sgarcia15/Heimdall/Recursos/Raspberry_Pi_Zero_ver_1.3_3_of_3_1024x1024.jpg

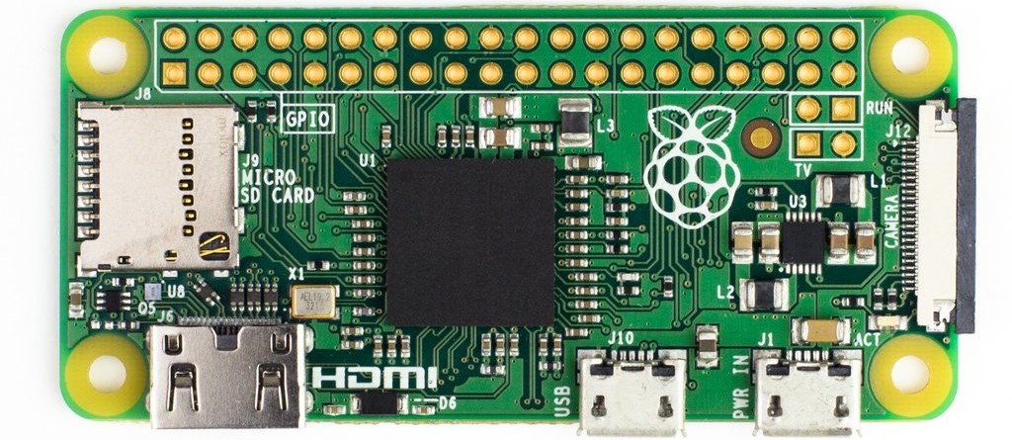
Recursos/Raspberry_Pi_Zero_ver_1.3_3_of_3_1024x1024.jpg
