sgarcia15/Heimdall/Recursos/CamVisible.jpg

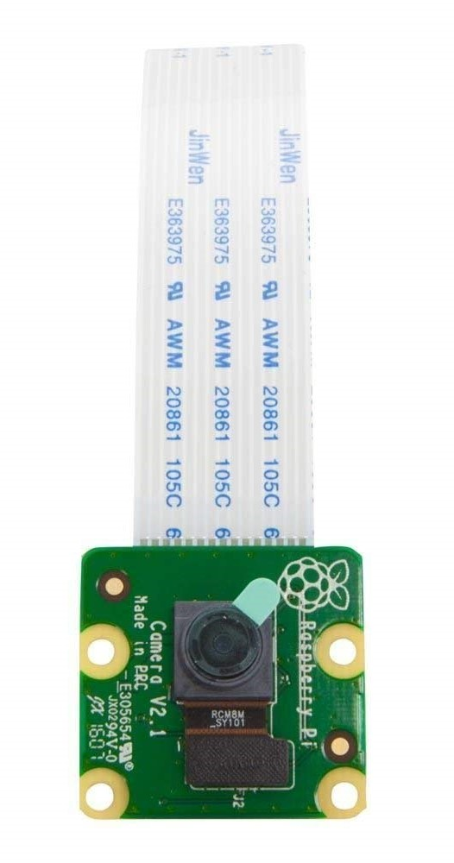
Recursos/CamVisible.jpg
