sgarcia15/Heimdall/Recursos/2017-10-14T00 17 29.457Z-Lepton Breakout Board - 2.5 - s.png

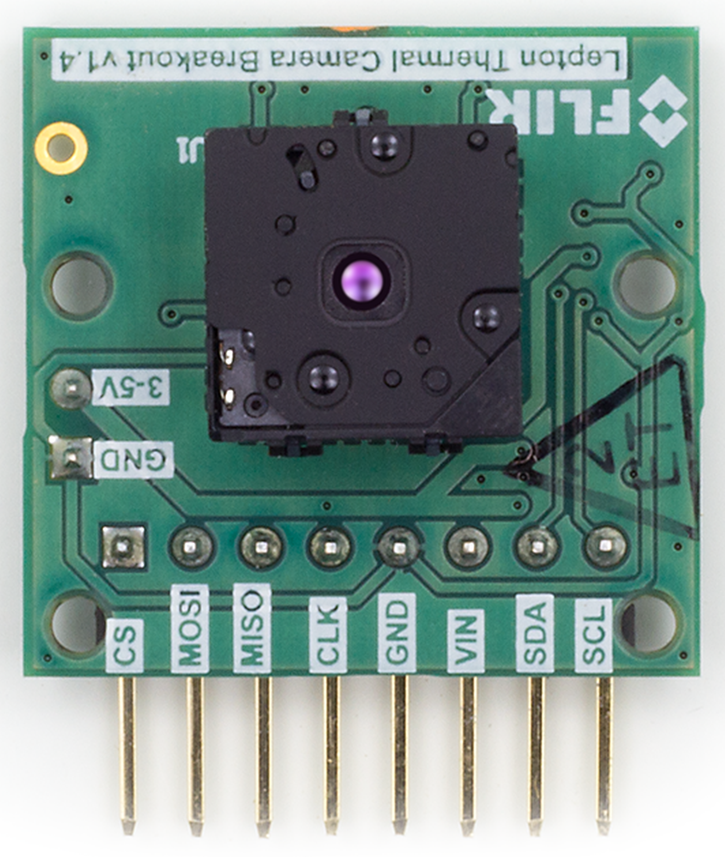
Recursos/2017-10-14T00 17 29.457Z-Lepton Breakout Board - 2.5 - s.png
