sgarcia15/Heimdall/Recursos/bitmap_tic150.png

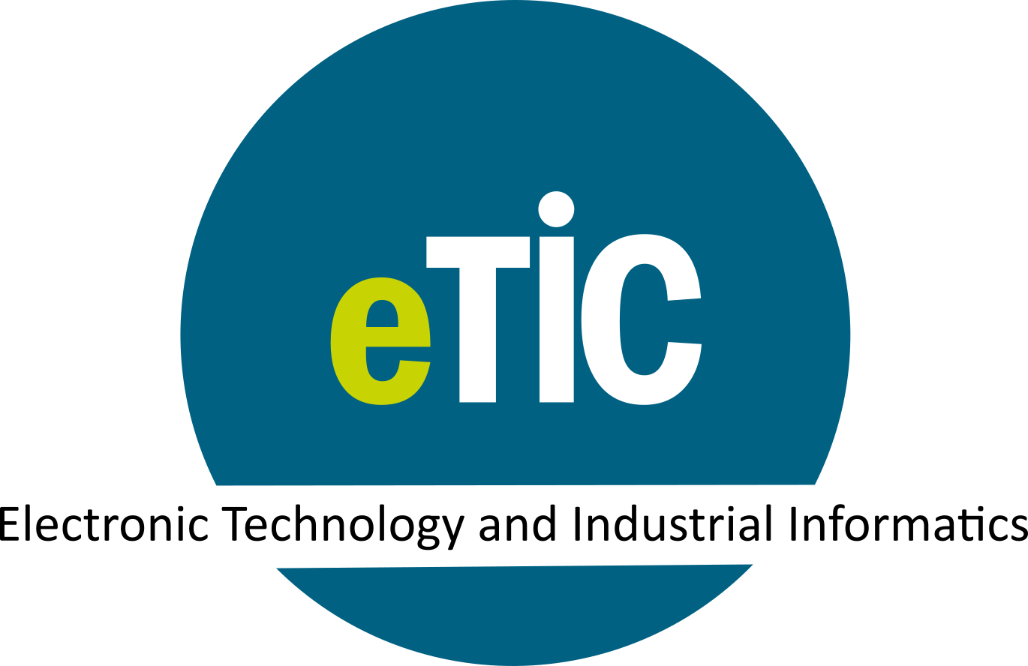
Recursos/bitmap_tic150.png
