sgarcia15/Heimdall/Recursos/bitmap_tic150_BN_nolet.png

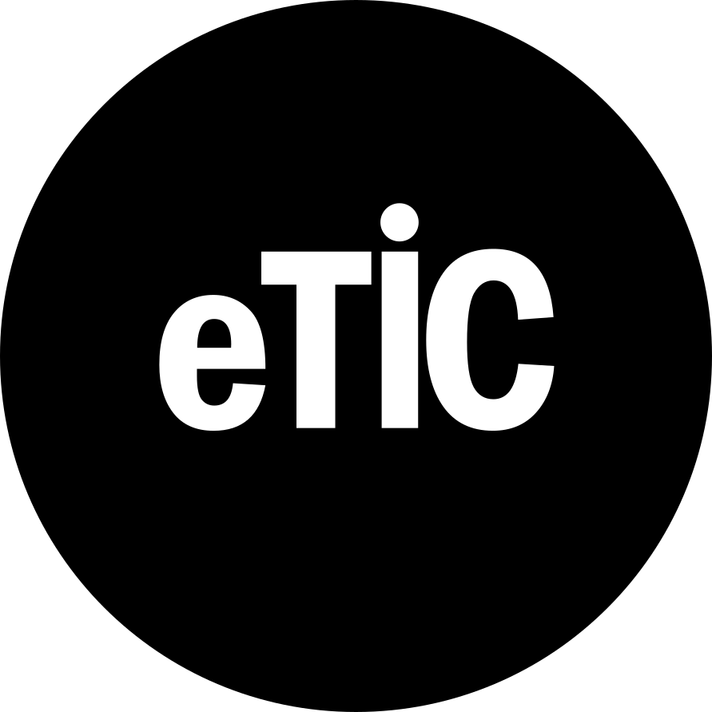
Recursos/bitmap_tic150_BN_nolet.png
