sgarcia15/Heimdall/BOM.xlsx

Sheet: Hoja1
Item | Schematic Ref | Qty | Category | Description | Part Number | Specific Part Number | Manufacturer | Comments | Packaging | Supplier | Supplier Ref | Alternative supplier | Sample? | Unit Price € | Total € |  | Total price
1 | U7 | 1 | PowerSupply | IC REG BUCK ADJ 3A SYNC 8SOICIC REG BUCK ADJ 3A SYNC 8SOIC | NCP3170B | NCP3170BDR | ON Semiconductor | Seleccted by Fran, It doesn't work well with low loads according to the datasheet. Ordered by Fran, we have 30, | SO-8 | Digikey | NCP3170BDR2GOSCT-ND |  | N | 0.972 | 0.972 |  | 0
 | U1 | 1 | PowerSupply | IC REG BUCK 3.3V 0.5A 8SOIC | MAX5033 | MAX5033AUSA | Maxim | Tested in the SEA proyect, works well with low loads | SO-8 | Digikey | MAX5033AUSA+-ND |  | Y | 2.985 | 2.985 |  | 0
 | U3 | 1 | Microcontroller | IC ARM® Cortex®-M3 STM32L1 32-bits 32 MHz Memoria FLASH 384 KB (384 K x 8) | STM32L162 | STM32L162RDT6 | STMicroelectronics | Price based on 10 units | 64-LQFP | Digikey | 497-17537-ND |  | N | 5.575 | 5.575 |  | 0
 | U6 | 1 | Digital Compass | Digital output magnetic sensor: ultra-low-power, high-performance 3-axis magnetometer | LIS2MDL | LIS2MDLTR | STMicroelectronics |  | 12-LGA | Digikey | 497-17588-1-ND |  | N | 1.399 | 1.399 |  | 0
 |  | 1 | Sensor | Humidity Temperature Sensor 0 ~ 100% RH I²C ±3% RH | HTU21D | HTU21D(F) | TE Connectivity |  | 6-DFN | Digikey | 223-1591-1-ND |  | N | 2.638 | 2.638 |  | 0
 | U8 | 1 | Thermal Camera | THERMAL IMAGE SENSOR 160HX120V | Lepton 3 | Lepton 3 | FLIR | This doesn't have the radiometry calibrated. The lepton 3,5 has the internal calibration but it isn't available on Digikey |  | Digikey | 500-0726-01-ND | Groupgets | N | 204.06 | 204.06 |  | 0
 |  | 1 | Camera | RASPBERRY PI CAMERA MODULE V2 |  |  | Raspberry Pi |  |  | Digikey | 1690-1011-ND | Amazon, Aliexpress | N | 25.53 | 25.53 |  | 0
 | U5 | 1 | Darlinton IC | ULN2003
 |  |  | Op Amp | General Purpose Quadruple Operational Amplifiers | LM324 | LM324DR | Texas Instruments |  | SOIC-14 | Digikey | 296-14597-1-ND |  | N | 0.252 | 0 |  | 0
 |  |  |  |  |  |  |  |  |  |  |  |  |  |  | 0 |  | 0
 | C1,C6,C7,C8,C9,C12,C13,C18,C20,C23,C24 | 11 | Ceramic Capacitor | CAP CER 0.1UF (100NF) 16V Y5V 0603 |  |  | Samsung Electro-Mechanics | General decoupling capacitor | 0603 | Digikey | 1276-1258-1-ND |  | N | 0.01032 | 0.11352 |  | 0
 | C19 | 1 | Ceramic Capacitor | CAP CER 0805 2.2NF 250V X7R 10% |  |  | KEMET | For the 5V power supply | 0805 | Digikey | 399-16649-1-ND |  | N | 0.161 | 0.161 |  | 0
 | C17, C22 | 2 | Ceramic Capacitor | CAP CER 22UF 6.3V 0805 |  |  |  | Ordered by Fran, we have 100, | 0805 | Digikey |  |  | N |  | 0 |  | 0
 | C16 | 1 | Ceramic Capacitor | CAP CER 10UF 6.3V X5R 0603 |  |  | Samsung Electro-Mechanics | For the digital compass | 0603 | Digikey | 1276-1119-1-ND |  | N | 0.104 | 0.104 |  | 0
 | C2 | 1 | Ceramic Capacitor | CAP CER 10000PF (10nF) 50V X7R 0603 |  |  | TDK Corporation | For the analog supply of the STM32 | 0603 | Digikey | 445-1311-1-ND |  | N | 0.026 | 0.026 |  | 0
 | C15 | 1 | Ceramic Capacitor | CAP CER 4.7UF 10V X5R 0603 |  |  | Samsung Electro-Mechanics | For the STM32 supply | 0603 | Digikey | 1276-6684-1-ND |  | N | 0.089 | 0.089 |  | 0
 | C10 | 1 | Electrolitic Capacitor | CAP ALUM 100UF 20% 25V SMD 160mOhm | EEE-FPE101XAP | EEE-FPE101XAP | Panasonic Electronic Components | Input capacitor | 6,3x5,8 | Digikey | PCE4546CT-ND |  | N | 0.42 | 0.42 |  | 0
 | C3,C4 | 2 | Ceramic Capacitor | CAP CER 12PF 10V C0G/NP0 0603 |  |  | Vishay Vitramon | Crystal decoupling capacitors | 0603 | Digikey | 720-1655-1-ND |  | N | 0.121 | 0.242 |  | 0
 | C21 | 1 | Ceramic Capacitor | CAP CER 0.22UF 16V X7R 0603 |  |  | Samsung Electro-Mechanics | For the digital compass | 0603 | Digikey | 1276-2010-1-ND |  | N | 0.0303 | 0.0303 |  | 0
 | C11 | 1 | Electrolitic Capacitor | CAP ALUM 33UF 20% 25V SMD | EEE-FP1E330AP | EEE-FP1E330AP | Panasonic Electronic Components | Low ESR 250mOhm for the 3,3V supply. | 6,3x7,7 | Digikey | PCE4541CT-ND |  | N | 0.339 | 0.339 |  | 0
 | C5 | 1 | Ceramic Capacitor | 1uF |  |  |  | Not ordered
 |  |  |  |  |  |  |  |  |  |  |  |  | N |  | 0 |  | 0
 | R8 | 1 | Resistor | 1/10 W ±1% 255 kOhms Película gruesa 0603 |  |  | Rohm Semiconductor |  | 0603 | Digikey | RHM255KCFCT-ND |  | N | 0.009 | 0.009 |  | 0
 | R1, R7 | 2 | Resistor | 1M OHM 5% 1/10W 0603 |  |  | Stackpole Electronics Inc. |  | 0603 | Digikey | RMCF0603JT1M00CT-ND |  | N | 0.011 | 0.022 |  | 0
 | R2,R9,R10,R11,R22,R23 | 6 | Resistor | 10K OHM 5% 1/10W 0603 |  |  | Stackpole Electronics Inc. |  | 0603 | Digikey | RMCF0603JG10K0CT-ND |  | N | 0.004 | 0.024 |  | 0
 | R3,R6,R12,R14,R20,R21 | 6 | Resistor | 100K OHM 1% 1/10W 0603 |  |  | Stackpole Electronics Inc. |  | 0603 | Digikey | RMCF0603FT100KCT-ND |  | N | 0.0059 | 0.0354 |  | 0
 | R15 | 1 | Resistor | 8.25K OHM 1% 1/10W 0603 |  |  | Stackpole Electronics Inc. | Filter for the 5V power supply | 0603 | Digikey | RMCF0603FT8K25CT-ND |  | N | 0.015 | 0.015 |  | 0
 | R4,R5,R18 | 3 | Resistor | 4.75K OHM 1% 1/10W 0603 |  |  | Stackpole Electronics Inc. |  | 0603 | Digikey | RMCF0603FT4K75CT-ND |  | N | 0.0059 | 0.0177 |  | 0
 | R17 | 2 | Resistor | 24.9K OHM 1% 1/8W 0603 |  |  | Stackpole Electronics Inc. |  | 0603 | Digikey | RNCP0603FTD24K9CT-ND |  | N | 0.0105 | 0.021 |  | 0
 | R13,R16,R19 | 3 | Resistor | 330 OHM 5% 1/10W 0603 |  |  | Stackpole Electronics Inc. | For the LEDs | 0603 | Digikey | RMCF0603JT330RCT-ND |  | N | 0.011 | 0.033 |  | 0
 |  |  |  |  |  |  |  |  |  |  |  |  | N |  | 0 |  | 0
 |  |  |  |  |  |  |  |  |  |  |  |  | N |  | 0 |  | 0
 |  |  |  |  |  |  |  |  |  |  |  |  | N |  | 0 |  | 0
 | Q1,Q2,Q3,Q4 | 4 | Transistor | Bipolar (BJT) Transistor NPN 40V 200mA 300MHz 300mW Surface Mount SC-75, SOT-416 | MMBT3904 | MMBT3904TT1G | ON Semiconductor | General use NPN transistor | SOT-23 | Digikey | MMBT3904TT1GOSCT-ND |  | N | 0.0382 | 0.1528 |  | 0
 | D2, D3 | 2 | LED | LED GREEN CLEAR 0805 SMD |  | LTST-C171GKT | Lite-On Inc. |  | 0805 | Digikey | 160-1423-1-ND |  | N | 0.1328 | 0.2656 |  | 0
 | D1 | 1 | Diode | DIODE SCHOTTKY 40V 1A | 1N5819 | 1N5819HW-7-F | Diodes Incorporated | For the 3,3V power supply | SOD123 | Digikey | 1N5819HW-FDICT-ND |  | N | 0.31 | 0.31 |  | 0
 | D4 | 1 | Diode Zener |  |  |  |  |  |  |  |  |  |  |  | 0 |  | 0
 |  |  |  |  |  |  |  |  |  |  |  |  |  |  | 0 |  | 0
 |  |  |  |  |  |  |  |  |  |  |  |  |  |  | 0 |  | 0
 | P4 | 1 | Connector | CONN HEADER XH TOP 5POS 2.5MM |  |  | JST Sales America Inc. | Stepper motor connector |  |  | 455-2270-ND |  | N | 0.202 | 0.202 |  | 0
 |  | 1 | Pigtail | Cable coaxial UMCC a Cable Hembra a cable Cable coaxial, 1.37 mm DE 6.000" (152.40 mm) |  |  | Molex, LLC | MCRF connector according to the datasheet |  |  | WM9588-ND |  | N | 2.049 | 2.049 |  | 0
 | J1 | 1 | Connector | Conector Coaxial ultraminiatura 50 Ohm |  |  | Molex, LLC | MCRF connector according to the datasheet | MCRF |  | WM5587CT-ND |  | N | 0.587 | 0.587 |  | 0
 | P9 | 1 | Double Connector | RJ11 6p4c double connector |  |  | Molex, LLC | For the rain gauge, anemometer and wind vane, | RJ11 |  | WM9177-ND |  | N | 1.278 | 1.278 |  | 0
 | P1 | 1 | Connector | TERM BLOCK 2POS 5.00MM PCB HORIZ STACKABLE |  | VI0201550000G | Amphenol Anytek |  | TH-5mm |  | 609-3927-ND |  | N | 0.2792 | 0.2792 |  | 0
 |  |  |  |  |  |  |  |  |  |  |  |  |  |  | 0 |  | 0
 |  |  |  |  |  |  |  |  |  |  |  |  |  |  | 0 |  | 0
 |  |  |  |  |  |  |  |  |  |  |  |  |  |  | 0 |  | 0
 | U2 | 1 | Comunication module | Integrated LoRa module based on the SX1276 |  |  |  |  |  |  |  |  | N |  | 0 |  | 0
 |  | 1 | Lepton breakout | LEPTON BREAKOUT BOARD PCB ASSY |  |  |  | Breakout socket fot the Lepton3 thermal camera | SIL-8 |  | 250-0587-00-ND |  | N | 34.14 | 34.14 |  | 0
 | Y1 | 1 | Crystal | CRYSTAL 32.7680KHZ 12.5PF T/H |  |  |  | RTC Crystal |  |  | 535-9034-ND |  | N | 0.118 | 0.118 |  | 0
 | L2 | 1 | Inductor | FIXED IND 3.3UH 7.5A 8.7 MOHM |  |  | Bourns Inc. | Inductivo Bobinado de alambre enrollado. 8.7 mOhm máx. |  |  | SDR1307-3R3MLCT-ND |  | N | 0.747 | 0.747 |  | 0
 | FB1 | 1 | Ferrite Bead | FERRITE BEAD, 60 Ohms @ 100MHz, 20mOhm @ DC |  |  | TDK Corporation | General decoupling bead | 0603 |  | 445-1563-1-ND |  | N | 0.0403 | 0.0403 |  | 0
 | U9 | 1 | Buttom |  |  |  |  |  |  |  |  |  |  |  | 0 |  | 0
 |  |  |  |  |  |  |  |  |  |  |  |  |  |  | 0 |  | 0
 |  |  |  |  |  |  |  |  |  |  |  |  |  |  | 0 |  | 0
1 | Total: | 103 |  |  |  |  |  |  |  |  |  |  |  |  | 285.02982 | 0 | 0

Sheet: Hoja2
Item | Schematic Ref | Qty | Category | Manufacturer | Packaging | Supplier Ref
1 | U7 | 1 | PowerSupply | ON Semiconductor | SO-8 | NCP3170BDR2GOSCT-ND
 | U1 | 1 | PowerSupply | Maxim | SO-8 | MAX5033AUSA+-ND
 | U3 | 1 | Microcontroller | STMicroelectronics | 64-LQFP | 497-17537-ND
 | U6 | 1 | Digital Compass | STMicroelectronics | 12-LGA | 497-17588-1-ND
 |  | 1 | Sensor | TE Connectivity | 6-DFN | 223-1591-1-ND
 | U8 | 1 | Thermal Camera | FLIR |  | 500-0726-01-ND
 |  | 1 | Camera | Raspberry Pi |  | 1690-1011-ND
 | U5 | 1 | Darlinton IC
 |  |  | Op Amp | Texas Instruments | SOIC-14 | 296-14597-1-ND
 | C1,C6,C7,C8,C9,C12,C13,C18,C20,C23,C24 | 11 | Ceramic Capacitor | Samsung Electro-Mechanics | 0603 | 1276-1258-1-ND
 | C19 | 1 | Ceramic Capacitor | KEMET | 0805 | 399-16649-1-ND
 | C17, C22 | 2 | Ceramic Capacitor |  | 0805
 | C16 | 1 | Ceramic Capacitor | Samsung Electro-Mechanics | 0603 | 1276-1119-1-ND
 | C2 | 1 | Ceramic Capacitor | TDK Corporation | 0603 | 445-1311-1-ND
 | C15 | 1 | Ceramic Capacitor | Samsung Electro-Mechanics | 0603 | 1276-6684-1-ND
 | C10 | 1 | Electrolitic Capacitor | Panasonic Electronic Components | 6,3x5,8 | PCE4546CT-ND
 | C3,C4 | 2 | Ceramic Capacitor | Vishay Vitramon | 0603 | 720-1655-1-ND
 | C21 | 1 | Ceramic Capacitor | Samsung Electro-Mechanics | 0603 | 1276-2010-1-ND
 | C11 | 1 | Electrolitic Capacitor | Panasonic Electronic Components | 6,3x7,7 | PCE4541CT-ND
 | C5 | 1 | Ceramic Capacitor
 | R8 | 1 | Resistor | Rohm Semiconductor | 0603 | RHM255KCFCT-ND
 | R1, R7 | 2 | Resistor | Stackpole Electronics Inc. | 0603 | RMCF0603JT1M00CT-ND
 | R2,R9,R10,R11,R22,R23 | 6 | Resistor | Stackpole Electronics Inc. | 0603 | RMCF0603JG10K0CT-ND
 | R3,R6,R12,R14,R20,R21 | 6 | Resistor | Stackpole Electronics Inc. | 0603 | RMCF0603FT100KCT-ND
 | R15 | 1 | Resistor | Stackpole Electronics Inc. | 0603 | RMCF0603FT8K25CT-ND
 | R4,R5,R18 | 3 | Resistor | Stackpole Electronics Inc. | 0603 | RMCF0603FT4K75CT-ND
 | R17 | 2 | Resistor | Stackpole Electronics Inc. | 0603 | RNCP0603FTD24K9CT-ND
 | R13,R16,R19 | 3 | Resistor | Stackpole Electronics Inc. | 0603 | RMCF0603JT330RCT-ND
 | Q1,Q2,Q3,Q4 | 4 | Transistor | ON Semiconductor | SOT-23 | MMBT3904TT1GOSCT-ND
 | D2, D3 | 2 | LED | Lite-On Inc. | 0805 | 160-1423-1-ND
 | D1 | 1 | Diode | Diodes Incorporated | SOD123 | 1N5819HW-FDICT-ND
 | D4 | 1 | Diode Zener
 | P4 | 1 | Connector | JST Sales America Inc. |  | 455-2270-ND
 |  | 1 | Pigtail | Molex, LLC |  | WM9588-ND
 | J1 | 1 | Connector | Molex, LLC | MCRF | WM5587CT-ND
 | P9 | 1 | Double Connector | Molex, LLC | RJ11 | WM9177-ND
 | P1 | 1 | Connector | Amphenol Anytek | TH-5mm | 609-3927-ND
 | U2 | 1 | Comunication module
 |  | 1 | Lepton breakout |  | SIL-8 | 250-0587-00-ND
 | Y1 | 1 | Crystal |  |  | 535-9034-ND
 | L2 | 1 | Inductor | Bourns Inc. |  | SDR1307-3R3MLCT-ND
 | FB1 | 1 | Ferrite Bead | TDK Corporation | 0603 | 445-1563-1-ND
 | U9 | 1 | Buttom
1 | Total: | 103

Sheet: Hoja3
Item | Schematic Ref | Qty | Description | Packaging | Supplier Ref
1 | U7 | 1 | IC REG BUCK ADJ 3A SYNC 8SOICIC REG BUCK ADJ 3A SYNC 8SOIC | SO-8 | NCP3170BDR2GOSCT-ND
 | U1 | 1 | IC REG BUCK 3.3V 0.5A 8SOIC | SO-8 | MAX5033AUSA+-ND
 | U3 | 1 | IC ARM® Cortex®-M3 STM32L1 32-bits 32 MHz Memoria FLASH 384 KB (384 K x 8) | 64-LQFP | 497-17537-ND
 | U6 | 1 | Digital output magnetic sensor: ultra-low-power, high-performance 3-axis magnetometer | 12-LGA | 497-17588-1-ND
 |  | 1 | Humidity Temperature Sensor 0 ~ 100% RH I²C ±3% RH | 6-DFN | 223-1591-1-ND
 | U8 | 1 | THERMAL IMAGE SENSOR 160HX120V |  | 500-0726-01-ND
 |  | 1 | RASPBERRY PI CAMERA MODULE V2 |  | 1690-1011-ND
 | U5 | 1 | ULN2003
 |  |  | General Purpose Quadruple Operational Amplifiers | SOIC-14 | 296-14597-1-ND
 | C1,C6,C7,C8,C9,C12,C13,C18,C20,C23,C24 | 11 | CAP CER 0.1UF (100NF) 16V Y5V 0603 | 0603 | 1276-1258-1-ND
 | C19 | 1 | CAP CER 0805 2.2NF 250V X7R 10% | 0805 | 399-16649-1-ND
 | C17, C22 | 2 | CAP CER 22UF 6.3V 0805 | 0805
 | C16 | 1 | CAP CER 10UF 6.3V X5R 0603 | 0603 | 1276-1119-1-ND
 | C2 | 1 | CAP CER 10000PF (10nF) 50V X7R 0603 | 0603 | 445-1311-1-ND
 | C15 | 1 | CAP CER 4.7UF 10V X5R 0603 | 0603 | 1276-6684-1-ND
 | C10 | 1 | CAP ALUM 100UF 20% 25V SMD 160mOhm | 6,3x5,8 | PCE4546CT-ND
 | C3,C4 | 2 | CAP CER 12PF 10V C0G/NP0 0603 | 0603 | 720-1655-1-ND
 | C21 | 1 | CAP CER 0.22UF 16V X7R 0603 | 0603 | 1276-2010-1-ND
 | C11 | 1 | CAP ALUM 33UF 20% 25V SMD | 6,3x7,7 | PCE4541CT-ND
 | C5 | 1 | 1uF
 | R8 | 1 | 1/10 W ±1% 255 kOhms Película gruesa 0603 | 0603 | RHM255KCFCT-ND
 | R1, R7 | 2 | 1M OHM 5% 1/10W 0603 | 0603 | RMCF0603JT1M00CT-ND
 | R2,R9,R10,R11,R22,R23 | 6 | 10K OHM 5% 1/10W 0603 | 0603 | RMCF0603JG10K0CT-ND
 | R3,R6,R12,R14,R20,R21 | 6 | 100K OHM 1% 1/10W 0603 | 0603 | RMCF0603FT100KCT-ND
 | R15 | 1 | 8.25K OHM 1% 1/10W 0603 | 0603 | RMCF0603FT8K25CT-ND
 | R4,R5,R18 | 3 | 4.75K OHM 1% 1/10W 0603 | 0603 | RMCF0603FT4K75CT-ND
 | R17 | 2 | 24.9K OHM 1% 1/8W 0603 | 0603 | RNCP0603FTD24K9CT-ND
 | R13,R16,R19 | 3 | 330 OHM 5% 1/10W 0603 | 0603 | RMCF0603JT330RCT-ND
 | Q1,Q2,Q3,Q4 | 4 | Bipolar (BJT) Transistor NPN 40V 200mA 300MHz 300mW Surface Mount SC-75, SOT-416 | SOT-23 | MMBT3904TT1GOSCT-ND
 | D2, D3 | 2 | LED GREEN CLEAR 0805 SMD | 0805 | 160-1423-1-ND
 | D1 | 1 | DIODE SCHOTTKY 40V 1A | SOD123 | 1N5819HW-FDICT-ND
 | D4 | 1
 | P4 | 1 | CONN HEADER XH TOP 5POS 2.5MM |  | 455-2270-ND
 |  | 1 | Cable coaxial UMCC a Cable Hembra a cable Cable coaxial, 1.37 mm DE 6.000" (152.40 mm) |  | WM9588-ND
 | J1 | 1 | Conector Coaxial ultraminiatura 50 Ohm | MCRF | WM5587CT-ND
 | P9 | 1 | RJ11 6p4c double connector | RJ11 | WM9177-ND
 | P1 | 1 | TERM BLOCK 2POS 5.00MM PCB HORIZ STACKABLE | TH-5mm | 609-3927-ND
 | U2 | 1 | Integrated LoRa module based on the SX1276
 |  | 1 | LEPTON BREAKOUT BOARD PCB ASSY | SIL-8 | 250-0587-00-ND
 | Y1 | 1 | CRYSTAL 32.7680KHZ 12.5PF T/H |  | 535-9034-ND
 | L2 | 1 | FIXED IND 3.3UH 7.5A 8.7 MOHM |  | SDR1307-3R3MLCT-ND
 | FB1 | 1 | FERRITE BEAD, 60 Ohms @ 100MHz, 20mOhm @ DC | 0603 | 445-1563-1-ND
 | U9 | 1
1 | Total: | 103

Sheet: EB
Item | Schematic Ref | Qty | Description | Packaging | Supplier Ref
 | U1 | 1 | IC REG BUCK 3.3V 0.5A 8SOIC | SO-8 | MAX5033AUSA+-ND
 | U3 | 1 | IC ARM® Cortex®-M3 STM32L1 32-bits 32 MHz Memoria FLASH 384 KB (384 K x 8) | 64-LQFP | 497-17537-ND
 | C1,C6,C7,C8,C9,C12,C13 | 7 | CAP CER 0.1UF (100NF) 16V Y5V 0603 | 0603 | 1276-1258-1-ND
 | C2 | 1 | CAP CER 10000PF (10nF) 50V X7R 0603 | 0603 | 445-1311-1-ND
 | C15 | 1 | CAP CER 4.7UF 10V X5R 0603 | 0603 | 1276-6684-1-ND
 | C10 | 1 | CAP ALUM 100UF 20% 25V SMD 160mOhm | 6,3x5,8 | PCE4546CT-ND
 | C11 | 1 | CAP ALUM 33UF 20% 25V SMD | 6,3x7,7 | PCE4541CT-ND
 | C5 | 1 | 1uF
 | R8 | 1 | 1/10 W ±1% 255 kOhms Película gruesa 0603 | 0603 | RHM255KCFCT-ND
 | R7 | 1 | 1M OHM 5% 1/10W 0603 | 0603 | RMCF0603JT1M00CT-ND
 | R2,R11,R23 | 3 | 10K OHM 5% 1/10W 0603 | 0603 | RMCF0603JG10K0CT-ND
 | R3,R6,R14 | 3 | 100K OHM 1% 1/10W 0603 | 0603 | RMCF0603FT100KCT-ND
 | R13 | 1 | 330 OHM 5% 1/10W 0603 | 0603 | RMCF0603JT330RCT-ND
 | Q1,Q4 | 2 | Bipolar (BJT) Transistor NPN 40V 200mA 300MHz 300mW Surface Mount SC-75, SOT-416 | SOT-23 | MMBT3904TT1GOSCT-ND
 | D2 | 1 | LED GREEN CLEAR 0805 SMD | 0805 | 160-1423-1-ND
 | D1 | 1 | DIODE SCHOTTKY 40V 1A | SOD123 | 1N5819HW-FDICT-ND
 | P4 | 1 | CONN HEADER XH TOP 5POS 2.5MM |  | 455-2270-ND
 |  | 1 | Cable coaxial UMCC a Cable Hembra a cable Cable coaxial, 1.37 mm DE 6.000" (152.40 mm) |  | WM9588-ND
 | J1 | 1 | Conector Coaxial ultraminiatura 50 Ohm | MCRF | WM5587CT-ND
 | P1 | 1 | TERM BLOCK 2POS 5.00MM PCB HORIZ STACKABLE | TH-5mm | 609-3927-ND
 | U2 | 1 | Integrated LoRa module based on the SX1276
 | FB1 | 1 | FERRITE BEAD, 60 Ohms @ 100MHz, 20mOhm @ DC | 0603 | 445-1563-1-ND
1 | Total: | 103
