sgarcia15/Heimdall/Datasheets/NCP3170 DWS.XLS

Sheet: Instructions
NCP3170 Design Sheet Directions
This spreadsheet calculates both system and component data for use with the NCP3170 3.0A Synchronous Buck converter. Comments are available in multiple cells within this spreadsheet and looks like shown below:
 | Cell with comment:
To read comment, place cursor on top of red mark in the upper right corner of the cell.
Inputs:
All input fields have a yellow background. This tool will calculate most of the required component values. In some instances, the user has an option to override the suggested value.
Note:
This spreadsheet is provided for guidance purposes only. It is believed to be accurate. However, the user is responsible for verifying all suggested values provided by this tool are correct.
These sheets are protected against changes in most cells, except where inputs are allowed. This has been done to assure the integrity of this spread sheet. It can not be modified by the user.
Any comments or suggestions regarding changes in this document should be sent to:
b.mccoy@onsemi.com
Created by: Bryan W. McCoy (ON Semiconductor)
Rev. 3.0
Copyright, Semiconductor Component Industries, LLC, 2011

Sheet: System
NCP3170B | Input Voltage: |  | 5 | Output Voltage: |  | 3.3 | Efficiency: | 89.74% | IC Temperature: |  | 59.49535817 | ON Semiconductor
INPUT FIELDS |  |  |  |  |  | MIN | typ | MAX |  |  |  |  |  |  |  |  |  |  |  |  |  |  |  |  |  |  |  |  |  |  |  |  |  |  |  |  |  |  |  |  |  |  |  |  |  |  |  |  |  |  |  | Standard Capacitor Values |  | Standard R96 Resistor values
 | Min | Typ | Max | Unit | 0 | 0.9 | 0.9 | 0.9 | M | 2.3176 |  |  |  |  |  |  |  |  |  |  |  |  |  |  |  |  |  |  |  |  |  |  |  |  |  |  |  |  |  |  |  |  |  |  |  |  |  |  |  |  |  | 1 | 1 | 0.1 | 0.1
Input Voltage | 5 | 5 | 5 | V | 1.6 | 0.9 | 0.9 | 0.9 | G | 66.74639053 |  |  |  |  |  |  | hs | 0.6199490406 |  |  |  |  |  |  |  |  |  |  |  |  |  |  |  |  |  |  |  |  |  |  |  |  |  |  |  |  |  |  |  |  |  | 1.1 | 1.1 | 0.102 | 0.102
Efficiency Target | 90 | 90 | 90 | % | Typical Losses | 0.962 | R1 | 24000 | A | 1.172714001 |  |  |  | 24312.5 |  |  | ls | 0.2172057948 |  |  |  |  |  |  |  |  |  |  |  |  |  |  |  |  |  |  |  |  |  |  |  |  |  |  |  |  |  |  |  |  |  | 1.2 | 1.2 | 0.105 | 0.105
Output Voltage | 3.3 | 3.3 | 3.3 | V | min losses | 0.963 | R2 | 7680 | Y | 0.2424242424 |  |  |  | 7780 |  |  | IC | 0.04734152784 |  |  |  |  |  |  |  |  |  |  |  |  |  |  |  |  |  |  |  |  |  |  |  |  |  |  |  |  |  |  |  |  |  | 1.3 | 1.3 | 0.107 | 0.107
Average Output Current | 2.55 | 2.55 | 2.55 | A | 2pi | 6.283185307 | RF | 1000 | Fesr | 3617157.798 |  | 4.5 | ms |  |  |  |  | 0.8844963632 |  |  |  |  |  |  |  |  |  |  |  |  |  |  |  |  |  |  |  |  |  |  |  |  |  |  |  |  |  |  |  |  |  | 1.5 | 1.5 | 0.11 | 0.11
Output Ripple Voltage | 20 | 20 | 20 | mV | vramp | 1.10 | CF | 4.668544997e-10 | FP | 3084.433027 |  |  |  |  |  |  |  |  |  |  |  |  |  |  |  |  |  |  |  |  |  |  |  |  |  |  |  |  |  |  |  |  |  |  |  |  |  |  |  |  |  | 1.6 | 1.6 | 0.113 | 0.113
Transient Regulation |  | 5 |  | % | gm | 0.0002 | CC | 1.030110835e-08 | flc | 12645.69034 |  |  |  |  |  |  |  |  |  |  |  |  |  |  |  |  |  |  |  |  |  |  |  |  |  |  |  |  |  |  |  |  |  |  |  |  |  |  |  |  |  | 1.8 | 1.8 | 0 | 0
Transient Current |  | 1 |  | A | NCP3170A |  | RC | 5009.11 | fpo | 749.1042 |  |  |  |  |  |  |  |  |  |  |  |  |  |  |  |  |  |  |  |  |  |  |  |  |  |  |  |  |  |  |  |  |  |  |  |  |  |  |  |  |  | 2 | 2 | 0 | 0
Input Ripple Voltage | 30 | 50 | 110 | mV | NCP3170B |  | CP | 8.783990247e-12 |  |  |  |  |  | 1.51 |  |  |  |  |  |  |  |  |  |  |  |  |  |  |  |  |  |  |  |  |  |  |  |  |  |  |  |  |  |  |  |  |  |  |  |  |  | 2.2 | 2.2 | 0.127 | 0.127
Ambient Temperature | 25 | 25 | 25 | C |  |  |  |  |  |  |  |  | NCP3170A |  |  |  |  |  |  |  |  |  |  |  |  |  |  |  |  |  |  |  |  |  |  |  |  |  |  |  |  |  |  |  |  |  |  |  |  |  |  | 2.4 | 2.4 | 0.13 | 0.13
fcross |  | 50 |  | kHz | fcross |  | 50000 |  | MIN | 5.0 |  |  | NCP3170A |  |  |  |  |  |  |  |  |  |  |  |  |  |  |  |  |  |  |  |  |  |  |  |  |  |  |  |  |  |  |  |  |  |  |  |  |  |  | 2.7 | 2.7 | 0.133 | 0.133
 | Width | Length | oz |  |  |  |  |  | OUTPUT | 3.25 |  |  | NCP3170B |  |  |  |  |  |  |  |  |  |  |  |  |  |  |  |  |  |  |  |  |  |  |  |  |  |  |  |  |  |  |  |  |  |  |  |  |  |  | 3 | 3 | 0.137 | 0.137
Input PCB trace width | 11.28 | 28 | 1 | mm | width | length | Carea | Rtrace |  |  |  |  |  |  |  |  |  |  |  |  |  |  |  |  |  |  |  |  |  |  |  |  |  |  |  |  |  |  |  |  |  |  |  |  |  |  |  |  |  |  |  | 3.3 | 3.3 | 0.14 | 0.14
Switch PCB trace width | 7 | 9 | 1 | mm | 444.0944882 | 1.102362205 | 611.9622047 | 0.001246989161 | 0.001819557951 |  |  |  |  |  |  |  |  |  |  |  |  |  |  |  |  |  |  |  |  |  |  |  |  |  |  |  |  |  |  |  |  |  |  |  |  |  |  |  |  |  |  | 3.6 | 3.6 | 0.143 | 0.143
Output PCB trace width | 12.7 | 40 | 1 | mm | 275.5905512 | 0.3543307087 | 379.7637795 | 0.0006458894879 | 0.004221770855 |  |  |  |  |  |  |  |  |  |  |  |  |  |  |  |  |  |  |  |  |  |  |  |  |  |  |  |  |  |  |  |  |  |  |  |  |  |  |  |  |  |  | 3.9 | 3.9 | 0.147 | 0.14
 |  |  |  |  | 500 | 1.57480315 | 689 | 0.001582231466 | 0.01028846011 |  |  |  |  |  |  |  |  |  |  |  |  |  |  |  |  |  |  |  |  |  |  |  |  |  |  |  |  |  |  |  |  |  |  |  |  |  |  |  |  |  |  | 4.3 | 4.3 | 0.143 | 0.143
OUTPUT FIELDS |  |  |  |  | Selected Values |  |  |  |  |  |  |  |  |  |  |  |  |  |  |  |  |  |  |  |  |  |  |  |  |  |  |  |  |  |  |  |  |  |  |  |  |  |  |  |  |  |  |  |  |  |  | 4.7 | 4.7 | 0.147 | 0.147
 | Min | Typ | Max | Unit |  |  | Efficiency |  |  | 5 | V |  |  |  |  |  |  |  |  |  |  |  |  |  |  |  |  |  |  |  |  |  |  |  |  |  |  |  |  |  |  |  |  |  |  |  |  |  |  |  |  | 5.1 | 5.1 | 0.15 | 0.15
Frequency | 1000.0 | 1000.0 | 1000.0 | kHz |  |  | Evaluation at |  |  | 2.55 | A |  |  |  |  |  |  |  |  |  |  |  |  |  |  |  |  |  |  |  |  |  |  |  |  |  |  |  |  |  |  |  |  |  |  |  |  |  |  |  |  | 5.6 | 5.6 | 0.154 | 0.154
Output Inductance | 1.1 | 1.8 | 4.4 | μH | 3.60 |  | HS MOSFET Conduction Loss |  | 0.422 | 43.86977902% | A |  |  | User Input |  |  |  |  |  |  |  |  |  |  |  |  |  |  |  |  |  |  |  |  |  |  |  |  |  |  |  |  |  |  |  |  |  |  |  |  |  | 6.2 | 6.2 | 0.158 | 0.158
Inductor RMS Current | 2.6 | 2.6 | 2.6 | ARMS | 2.57 |  | HS MOSFET Switching Loss |  | 0.157 | 16.31014019% | B |  |  | Recommended Values |  |  |  |  |  |  |  |  |  |  |  |  |  |  |  |  |  |  |  |  |  |  |  |  |  |  |  |  |  |  |  |  |  |  |  |  |  | 6.8 | 6.8 | 0.162 | 0.162
Inductor Peak Current | 3.1 | 2.9 | 2.7 | APK | 3.12 |  | HS MOSFET DS Loss |  | 0.003 | 0.3442124066% | C |  |  |  |  |  |  |  |  |  |  |  |  |  |  |  |  |  |  |  |  |  |  |  |  |  |  |  |  |  |  |  |  |  |  |  |  |  |  |  |  | 7.5 | 7.5 | 0.165 | 0.165
Inductor DCR | 1.0 | 1.0 | 1.0 | mΩ | 9.1 |  | HS MOSFET QRR Loss |  | 0.037 | 3.896744226% | D |  |  | Calculated Values from User Selections |  |  |  |  |  |  |  |  |  |  |  |  |  |  |  |  |  |  |  |  |  |  |  |  |  |  |  |  |  |  |  |  |  |  |  |  |  | 8.2 | 8.2 | 0.169 | 0.169
Ripple Current Ratio | 40 | 25 | 10 | % | 34.9 |  | LS MOSFET Conduction Loss |  | 0.067 | 7.006576208% | E |  |  |  |  |  |  |  |  |  |  |  |  |  |  |  |  |  |  |  |  |  |  |  |  |  |  |  |  |  |  |  |  |  |  |  |  |  |  |  |  | 9.1 | 9.1 | 0.174 | 0.174
Output Capacitance |  | 295.6864564 |  | μF | 44 |  | LS MOSFET Body Diode Loss |  | 0.150 | 15.56427333% | F |  |  |  |  |  |  |  |  |  |  |  |  |  |  |  |  |  |  |  |  |  |  |  |  |  |  |  |  |  |  |  |  |  |  |  |  |  |  |  |  | 10 | 10 | 0.178 | 0.178
Output ESR | 16 | 16 | 16 | mΩ | 1 |  | Control Dissipation |  | 0.047 | 4.919408674% | G |  |  |  |  |  |  |  |  |  |  |  |  |  |  |  |  |  |  |  |  |  |  |  |  |  |  |  |  |  |  |  |  |  |  |  |  |  |  |  |  | 11 | 11 | 0.182 | 0.182
Output Capacitor RMS Current | 0.294 | 0.184 | 0.074 | ARMS | 0.257 |  | Inductor Losses |  | 0.059 | 6.15648299% | H |  |  | Power Dissipations |  |  |  |  |  |  |  |  |  |  |  |  |  |  |  |  |  |  |  |  |  |  |  |  |  |  |  |  |  |  |  |  |  |  |  |  |  | 12 | 12 | 0.187 | 0.187
Output Capacitor Voltage Rating | 3.3 | 4.9 | 6.6 | V |  |  | Input Capacitor Losses |  | 0.001 | 0.1255226905% | I |  |  |  |  |  |  |  |  |  |  |  |  |  |  |  |  |  |  |  |  |  |  |  |  |  |  |  |  |  |  |  |  |  |  |  |  |  |  |  |  | 13 | 13 | 0.191 | 0.191
Input Capacitance |  | 549.0715304 |  | μF | 22 |  | Output Capacitor Losses |  | 0.0003116666667 | 0.03238627423% | J |  |  | Feedback Diagram |  |  |  |  |  |  |  |  |  |  |  |  |  |  |  |  |  |  |  |  |  |  |  |  |  |  |  |  |  |  |  |  |  |  |  |  |  | 15 | 15 | 0.196 | 0.196
Input Capacitor ESR | 19.86825087 | 33.11375144 | 72.85025318 | mΩ | 1 |  | PCB Traces 1oz Copper |  | 0.017 | 1.774473984% | K |  |  |  |  |  |  |  |  |  |  |  |  |  |  |  |  |  |  |  |  |  |  |  |  |  |  |  |  |  |  |  |  |  |  |  |  |  |  |  |  | 16 | 16 | 0.2 | 0.2
Input Capacitor RMS Current | 1.208 | 1.208 | 1.208 | ARMS | 1.23 |  | Total Losses |  | 0.962 | W |  |  |  | Input Out of Range |  |  |  |  |  |  |  |  |  |  |  |  |  |  |  |  |  |  |  |  |  |  |  |  |  |  |  |  |  |  |  |  |  |  |  |  |  | 18 | 18 | 0.205 | 0.205
Input Capacitor Voltage Rating | 5 | 7.5 | 10 | V |  |  | Efficiency |  | 89.7% |  |  |  |  |  |  |  |  |  |  |  |  |  |  |  |  |  |  |  |  |  |  |  |  |  |  |  |  |  |  |  |  |  |  |  |  |  |  |  |  |  |  | 20 | 20 | 0.21 | 0.21
Vout Discharge |  | 16 |  | mV | 32.0855615 |  | Inrush 1 | 21.393 | A |  |  |  |  |  |  |  |  |  |  |  |  |  |  |  |  |  |  |  |  |  |  |  |  |  |  |  |  |  |  |  |  |  |  |  |  |  |  |  |  |  |  | 22 | 22 | 0.215 | 0.215
Ripple Voltage |  | 11.18 |  | mV | 7.223243802 |  | IOC Inrush | 0.984 | A | ICLR | 1.47 | A |  |  |  |  |  |  |  |  |  |  |  |  |  |  |  |  |  |  |  |  |  |  |  |  |  |  |  |  |  |  |  |  |  |  |  |  |  |  |  | 24 | 24 | 0.221 | 0.221
 | Suggested Standard Value |  |  |  |  | A more in-depth analysis can be achieved with the comp calc tool |  |  |  |  |  |  |  |  |  |  |  |  |  |  |  |  |  |  |  |  |  |  |  |  |  |  |  |  |  |  |  |  |  |  |  |  |  |  |  |  |  |  |  |  |  | 27 | 27 | 0.226 | 0.226
R1 |  | 23.70 |  | kΩ | 24.31 |  |  |  |  |  |  |  |  |  |  |  |  |  |  |  |  |  |  |  |  |  |  |  |  |  |  |  |  |  |  |  |  |  |  |  |  |  |  |  |  |  |  |  |  |  |  | 30 | 30 | 0.232 | 0.232
R2 |  | 7.68 |  | kΩ | 7.78 |  |  |  |  |  |  |  |  |  |  |  |  |  |  |  |  |  |  |  |  |  |  |  |  |  |  |  |  |  |  |  |  |  |  |  |  |  |  |  |  |  |  |  |  |  |  | 33 | 33 | 0.237 | 0.237
RF |  | 1.00 |  | kΩ | 1.00 |  |  |  |  |  |  |  |  |  |  |  |  |  |  |  |  |  |  |  |  |  |  |  |  |  |  |  |  |  |  |  |  |  |  |  |  |  |  |  |  |  |  |  |  |  |  | 36 | 36 | 0.243 | 0.243
CF |  | 430 |  | pF |  |  |  |  |  |  |  |  |  |  |  |  |  |  |  |  |  |  |  |  |  |  |  |  |  |  |  |  |  |  |  |  |  |  |  |  |  |  |  |  |  |  |  |  |  |  |  | 39 | 39 | 0.249 | 0.249
CC |  | 10 |  | nF |  |  |  |  |  |  |  |  |  |  |  |  |  |  |  |  |  |  |  |  |  |  |  |  |  |  |  |  |  |  |  |  |  |  |  |  |  |  |  |  |  |  |  |  |  |  |  | 43 | 43 | 0.255 | 0.255
RC |  | 4.99 |  | kΩ |  |  |  |  |  |  |  |  |  |  |  |  |  |  |  |  |  |  |  |  |  |  |  |  |  |  |  |  |  |  |  |  |  |  |  |  |  |  |  |  |  |  |  |  |  |  |  | 47 | 47 | 0.261 | 0.261
CP |  | 8.2 |  | pF |  |  |  |  |  |  |  |  |  |  |  |  |  |  |  |  |  |  |  |  |  |  |  |  |  |  |  |  |  |  |  |  |  |  |  |  |  |  |  |  |  |  |  |  |  |  |  | 51 | 51 | 0.267 | 0.267
flc |  | 12.65 |  | kHz |  |  |  |  |  |  |  |  |  |  |  |  |  |  |  |  |  |  |  |  |  |  |  |  |  |  |  |  |  |  |  |  |  |  |  |  |  |  |  |  |  |  |  |  |  |  |  | 56 | 56 | 0.274 | 0.274
fpo |  | 0.75 |  | kHz |  |  |  |  |  |  |  |  |  |  |  |  |  |  |  |  |  |  |  |  |  |  |  |  |  |  |  |  |  |  |  |  |  |  |  |  |  |  |  |  |  |  |  |  |  |  |  | 62 | 62 | 0.28 | 0.28
Fesr |  | 3617.16 |  | kHz |  |  |  |  |  |  |  |  |  |  |  |  |  |  |  |  |  |  |  |  |  |  |  |  |  |  |  |  |  |  |  |  |  |  |  |  |  |  |  |  |  |  |  |  |  |  |  | 68 | 68 | 0.287 | 0.287
 |  |  |  |  |  |  |  |  |  |  |  |  |  |  |  |  |  |  |  |  |  |  |  |  |  |  |  |  |  |  |  |  |  |  |  |  |  |  |  |  |  |  |  |  |  |  |  |  |  |  |  | 75 | 75 | 0.294 | 0.294
 |  |  |  |  |  |  |  |  |  |  |  |  |  |  |  |  |  |  |  |  |  |  |  |  |  |  |  |  |  |  |  |  |  |  |  |  |  |  |  |  |  |  |  |  |  |  |  |  |  |  |  | 82 | 82 | 0.301 | 0.301
 |  |  |  |  |  |  |  |  |  |  |  |  |  |  |  |  |  |  |  |  |  |  |  |  |  |  |  |  |  |  |  |  |  |  |  |  |  |  |  |  |  |  |  |  |  |  |  |  |  |  |  | 91 | 91 | 0.309 | 0.309
SDF | 10% |  |  |  |  |  |  |  |  |  |  | 2.3 |  |  |  | 32.1 |  |  |  |  |  |  |  |  |  |  |  |  |  |  |  |  |  |  |  |  |  |  |  |  |  |  |  |  |  |  |  |  |  |  |  | 100 | 100 | 0.316 | 0.316
Coesl | 1e-08 |  |  |  | Tran voltage deviation from cout discharge |  |  |  |  |  |  | 16.0 |  |  |  | 1.0 |  |  |  |  |  |  |  |  |  |  |  |  |  |  |  |  |  |  |  |  |  |  |  |  |  |  |  |  |  |  |  |  |  |  |  | 110 | 110 | 0.324 | 0.324
Coesr | 0.08 |  |  |  | Tran voltage deviation from esr |  |  |  |  |  |  | 4.2 |  |  |  |  |  |  |  |  |  |  |  |  |  |  |  |  |  |  |  |  |  |  |  |  |  |  |  |  |  |  |  |  |  |  |  |  |  |  |  | 120 | 120 | 0.332 | 0.332
CO | 0.00047 |  |  |  | Recommended Output Capacitor from transient |  |  |  |  |  |  | 295.7 |  |  |  |  |  |  |  |  |  |  |  |  |  |  |  |  |  |  |  |  |  |  |  |  |  |  |  |  |  |  |  |  |  |  |  |  |  |  |  | 130 | 130 | 0.34 | 0.34
Itran | 2 |  |  |  | Recommended Output Capacitor from ripple |  |  |  |  |  |  | 549.1 |  |  |  |  |  |  |  |  |  |  |  |  |  |  |  |  |  |  |  |  |  |  |  |  |  |  |  |  |  |  |  |  |  |  |  |  |  |  |  | 150 | 150 | 0.348 | 0.348
Inductance Selected | 1.8e-05 |  |  |  | Recommended Input Capacitor from ripple |  |  |  |  |  |  |  |  |  |  |  |  |  |  |  |  |  |  |  |  |  |  |  |  |  |  |  |  |  |  |  |  |  |  |  |  |  |  |  |  |  |  |  |  |  |  | 160 | 160 | 0.357 | 0.357
 | vin | vout | D | RA |  | IOUT | L | L OUT1 | rms L | LPK L | Slew Rate | lPP | COrms | vtranesr (mv) |  | In RMS | Vesl on | Vesl off |  |  |  |  |  |  |  |  |  |  |  |  |  |  |  |  |  |  |  |  |  |  |  |  |  |  |  |  |  |  |  |  |  | 180 | 180 | 0.365 | 0.365
 | 5 | 3.3 | 0.660 | 10% | FSW | 2.55 | 4.4e-06 | 4.4 | 2.551062279 | 2.6775 | 0.39 | 0.255 | 0.074 | 0 |  | 1.2 |  |  |  |  |  |  |  |  |  |  |  |  |  |  |  |  |  |  |  |  |  |  |  |  |  |  |  |  |  |  |  |  |  |  |  | 200 | 200 | 0.374 | 0.374
 | 5 | 3.3 | 0.660 | 11% | 1000000 | 2.55 | 4e-06 | 4.0 | 2.551285301 | 2.69025 | 0.42 | 0.280 | 0.081 | 0 |  | 1.2 |  |  |  |  |  |  |  |  |  |  |  |  |  |  |  |  |  |  |  |  |  |  |  |  |  |  |  |  |  |  |  |  |  |  |  | 220 | 220 | 0.383 | 0.383
 | 5 | 3.3 | 0.660 | 12% | 1000000 | 2.55 | 3.666666667e-06 | 3.7 | 2.551529541 | 2.703 | 0.46 | 0.306 | 0.088 | 0 |  | 1.2 |  |  |  |  |  |  |  |  |  |  |  |  |  |  |  |  |  |  |  |  |  |  |  |  |  |  |  |  |  |  |  |  |  |  |  | 240 | 240 | 0.392 | 0.392
 | 5 | 3.3 | 0.660 | 13% | 1000000 | 2.55 | 3.384615385e-06 | 3.4 | 2.551794993 | 2.71575 | 0.50 | 0.331 | 0.096 | 0 |  | 1.2 |  |  |  |  |  |  |  |  |  |  |  |  |  |  |  |  |  |  |  |  |  |  |  |  |  |  |  |  |  |  |  |  |  |  |  | 270 | 270 | 0.402 | 0.402
 | 5 | 3.3 | 0.660 | 14% | 1000000 | 2.55 | 3.142857143e-06 | 3.1 | 2.55208165 | 2.7285 | 0.54 | 0.357 | 0.103 | 0 |  | 1.2 |  |  |  |  |  |  |  |  |  |  |  |  |  |  |  |  |  |  |  |  |  |  |  |  |  |  |  |  |  |  |  |  |  |  |  | 300 | 300 | 0.412 | 0.412
 | 5 | 3.3 | 0.660 | 15% | 1000000 | 2.55 | 2.933333333e-06 | 2.9 | 2.552389505 | 2.74125 | 0.58 | 0.382 | 0.110 | 0 |  | 1.2 |  |  |  |  |  |  |  |  |  |  |  |  |  |  |  |  |  |  |  |  |  |  |  |  |  |  |  |  |  |  |  |  |  |  |  | 330 | 330 | 0.422 | 0.422
 | 5 | 3.3 | 0.660 | 16% | 1000000 | 2.55 | 2.75e-06 | 2.8 | 2.552718551 | 2.754 | 0.62 | 0.408 | 0.118 | 0 |  | 1.2 |  |  |  |  |  |  |  |  |  |  |  |  |  |  |  |  |  |  |  |  |  |  |  |  |  |  |  |  |  |  |  |  |  |  |  | 360 | 360 | 0.432 | 0.432
 | 5 | 3.3 | 0.660 | 17% | 1000000 | 2.55 | 2.588235294e-06 | 2.6 | 2.553068778 | 2.76675 | 0.66 | 0.433 | 0.125 | 0 |  | 1.2 |  |  |  |  |  |  |  |  |  |  |  |  |  |  |  |  |  |  |  |  |  |  |  |  |  |  |  |  |  |  |  |  |  |  |  | 390 | 390 | 0.442 | 0.442
 | 5 | 3.3 | 0.660 | 18% | 1000000 | 2.55 | 2.444444444e-06 | 2.4 | 2.553440179 | 2.7795 | 0.70 | 0.459 | 0.133 | 0 |  | 1.2 |  |  |  |  |  |  |  |  |  |  |  |  |  |  |  |  |  |  |  |  |  |  |  |  |  |  |  |  |  |  |  |  |  |  |  | 430 | 430 | 0.453 | 0.453
 | 5 | 3.3 | 0.660 | 19% | 1000000 | 2.55 | 2.315789474e-06 | 2.3 | 2.553832745 | 2.79225 | 0.73 | 0.484 | 0.140 | 0 |  | 1.2 |  |  |  |  |  |  |  |  |  |  |  |  |  |  |  |  |  |  |  |  |  |  |  |  |  |  |  |  |  |  |  |  |  |  |  | 470 | 470 | 0.464 | 0.464
 | 5 | 3.3 | 0.660 | 20% | 1000000 | 2.55 | 2.2e-06 | 2.2 | 2.554246464 | 2.805 | 0.77 | 0.510 | 0.147 | 0 |  | 1.2 |  |  |  |  |  |  |  |  |  |  |  |  |  |  |  |  |  |  |  |  |  |  |  |  |  |  |  |  |  |  |  |  |  |  |  | 510 | 510 | 0.475 | 0.475
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
F | 1 | MHz | 1000000 |  |  |  |  |  |  |  |  |  |  |  |  |  |  |  |  |  |  |  |  |  |  |  |  |  |  |  |  |  | -50 | 0.68 |  |  |  |  |  |  |  |  |  |  |  |  |  |  |  |  |  |  |  | 11.3 | 11.3
Pcoreloss | 0.0100 | W |  |  |  |  |  |  |  |  |  |  |  |  |  |  |  |  |  |  |  |  |  |  |  |  |  |  |  |  |  |  | 75 | 1.28 |  |  |  |  |  |  |  |  |  |  |  |  |  |  |  |  |  |  |  | 12.7 | 12.7
Rds ON HS | 0.081 | W | 0.026171248 |  |  |  |  |  |  |  |  |  |  |  |  |  |  |  |  |  |  |  |  |  |  |  |  |  |  |  |  |  | 100 | 1.43 |  |  |  |  |  |  |  |  |  |  |  |  |  |  |  |  |  |  |  | 13 | 13
Rds ON LS | 0.026 | W | 0.031167 |  |  |  |  |  |  |  |  |  |  |  |  |  |  |  |  |  |  |  |  |  |  |  |  |  |  |  |  |  | 125 | 1.59 |  |  |  |  |  |  |  |  |  |  |  |  |  |  |  |  |  |  |  | 13.3 | 13.3
Poverhead | 0.03 | W | 87 |  |  |  |  |  |  |  |  |  |  |  |  |  |  |  |  |  |  |  |  |  |  |  |  |  |  |  |  |  | 150 | 1.74 |  |  |  |  |  |  |  |  |  |  |  |  |  |  |  |  |  |  |  | 13.7 | 13.7
Package Theta | 87 | °C/W |  |  |  |  |  |  |  |  |  |  |  |  |  |  |  |  |  |  |  |  |  |  |  |  |  |  |  |  |  |  |  |  |  |  |  |  |  |  |  |  |  |  |  |  |  |  |  |  |  |  |  | 14 | 14
IPK HS amd LS | 3.156 | A |  |  |  |  |  |  |  |  |  |  |  |  |  |  |  |  |  |  |  |  |  |  |  |  |  |  |  |  |  |  |  |  |  |  |  |  |  |  |  |  |  |  |  |  |  |  |  |  |  |  |  | 14.3 | 14.3
IRMS LS | 1.75 | A |  |  |  |  |  |  |  |  |  |  |  |  |  |  |  |  |  |  |  |  |  |  |  |  |  |  |  |  |  |  |  |  |  |  |  |  |  |  |  |  |  |  |  |  |  |  |  |  |  |  |  | 14.7 | 14.7
IRMS HS | 2.44 | A |  |  |  |  |  |  |  |  |  |  |  |  |  |  |  |  |  |  |  |  |  |  |  |  |  |  |  |  |  |  |  |  |  |  |  |  |  |  |  |  |  |  |  |  |  |  |  |  |  |  |  | 15 | 15
IAVE LS | 1.02 | A |  |  |  |  |  |  |  |  |  |  |  |  |  |  |  |  |  |  |  |  |  |  |  |  |  |  |  |  |  |  |  |  |  |  |  |  |  |  |  |  |  |  |  |  |  |  |  |  |  |  |  | 15.4 | 15.4
IAVE HS | 1.98 | A |  |  |  |  |  |  |  |  |  |  |  |  |  |  |  |  |  |  |  |  |  |  |  |  |  |  |  |  |  |  |  |  |  |  |  |  |  |  |  |  |  |  |  |  |  |  |  |  |  |  |  | 15.8 | 15.8
Delta I | 0.31 | A |  |  |  |  |  |  |  |  |  |  |  |  |  |  |  |  |  |  |  |  |  |  |  |  |  |  |  |  |  |  |  |  |  |  |  |  |  |  |  |  |  |  |  |  |  |  |  |  |  |  |  | 16.2 | 16.2
Delta I Ratio | 0.01558333333 |  |  |  |  |  |  |  |  |  |  |  |  |  |  |  |  |  |  |  |  |  |  |  |  |  |  |  |  |  |  |  |  |  |  |  |  |  |  |  |  |  |  |  |  |  |  |  |  |  |  |  |  | 16.5 | 16.5
Imax | 20 |  | 0.7177405626 |  |  |  |  |  |  |  |  |  |  |  |  |  |  |  |  |  |  |  |  |  |  |  |  |  |  |  |  |  |  |  |  |  |  |  |  |  |  |  |  |  |  |  |  |  |  |  |  |  |  | 16.9 | 16.9
Overshoot | 100% |  |  |  |  |  |  |  |  |  |  |  |  |  |  |  |  |  |  |  |  |  |  |  |  |  |  |  |  |  |  |  |  |  |  |  |  |  |  |  |  |  |  |  |  |  |  |  |  |  |  |  |  | 17.4 | 17.4
Pswitching Mult |  |  |  |  |  |  |  |  |  |  |  |  |  |  |  |  |  |  |  |  |  |  |  |  |  |  |  |  |  |  |  |  |  |  |  |  |  |  |  |  |  |  |  |  |  |  |  |  |  |  |  |  |  | 17.8 | 17.8
1 | 1 = 100 % Switching Loss |  |  |  |  |  |  |  |  |  |  |  |  |  |  |  |  |  |  |  |  |  |  |  |  |  |  |  |  |  |  |  |  |  |  |  |  |  |  |  |  |  |  |  |  |  |  |  |  |  |  |  |  | 18.2 | 18.2
 | 0= 0 % Switching Loss |  |  |  |  |  |  |  |  |  |  |  |  |  |  |  |  |  |  |  |  |  |  |  |  |  |  |  |  |  |  |  |  |  |  |  |  |  |  |  |  |  |  |  |  |  |  |  |  |  |  |  |  | 18.7 | 18.7
 |  |  |  |  |  |  |  |  |  |  |  |  |  |  |  |  |  |  |  |  |  |  |  |  |  |  |  |  |  |  |  |  |  |  |  |  |  |  |  |  |  |  |  |  |  |  |  |  |  |  |  |  |  | 19.1 | 19.1
NOL | 4e-08 |  |  |  |  |  |  |  |  |  |  |  |  |  |  |  |  |  |  |  |  |  |  |  |  |  |  |  |  |  |  |  |  |  |  |  |  |  |  |  |  |  |  |  |  |  |  |  |  |  |  |  |  | 19.6 | 19.6
Vf | 0.7 |  |  |  |  |  |  |  |  |  |  |  |  |  |  |  |  |  |  |  |  |  |  |  |  |  |  |  |  |  |  |  |  |  |  |  |  |  |  |  |  |  |  |  |  |  |  |  |  |  |  |  |  | 20 | 20
NOL D | 8.00% |  |  |  |  |  |  |  |  |  |  |  |  |  |  |  |  |  |  |  |  |  |  |  |  |  |  |  |  |  |  |  |  |  |  |  |  |  |  |  |  |  |  |  |  |  |  |  |  |  |  |  |  | 20.5 | 20.5
 |  |  |  |  |  |  |  |  |  |  |  |  |  |  |  |  |  |  |  |  |  |  |  |  |  |  |  |  |  |  |  |  |  |  |  |  |  |  |  |  |  |  |  |  |  |  |  |  |  |  |  |  |  | 21 | 21
amb | 25.000 |  |  |  |  |  |  |  |  |  |  |  |  |  |  |  |  |  |  |  |  |  |  |  |  |  |  |  |  |  |  |  |  |  |  |  |  |  |  |  |  |  |  |  |  |  |  |  |  |  |  |  |  | 21.5 | 21.5
 |  |  |  |  |  |  |  |  |  |  |  |  |  |  |  |  |  |  |  |  |  |  |  |  |  |  |  |  |  |  |  |  |  |  |  |  |  |  |  |  |  |  |  |  |  |  |  |  |  |  |  |  |  | 22.1 | 22.1
Current Steps | 0.015 |  |  |  |  |  |  |  |  |  |  |  |  |  |  |  |  |  |  |  |  |  |  |  |  |  |  |  |  |  |  |  |  |  |  |  |  |  |  |  |  |  |  |  |  |  |  |  |  |  |  |  |  | 22.6 | 22.6
 |  |  |  |  |  |  |  |  |  |  |  |  |  |  |  |  |  |  |  |  |  |  |  |  |  |  |  |  |  |  |  |  |  |  |  |  |  |  |  |  |  |  |  |  |  |  |  |  |  |  |  |  |  | 23.2 | 23.2
max PHS pwr | 0.087 | W |  |  |  |  |  |  |  |  |  |  |  |  |  |  |  |  |  |  |  |  |  |  |  |  |  |  |  |  |  |  |  |  |  |  |  |  |  |  |  |  |  |  |  |  |  |  |  |  |  |  |  | 23.7 | 23.7
max PLS pwr | 0.026 | W |  |  |  |  |  |  |  |  |  |  |  |  |  |  |  |  |  |  |  |  |  |  |  |  |  |  |  |  |  |  |  |  |  |  |  |  |  |  |  |  |  |  |  |  |  |  |  |  |  |  |  | 24.3 | 24.3
max L pwr | 0.002 | W |  |  |  |  |  |  |  |  |  |  |  |  |  |  |  |  |  |  |  |  |  |  |  |  |  |  |  |  |  |  |  |  |  |  |  |  |  |  |  |  |  |  |  |  |  |  |  |  |  |  |  | 24.9 | 24.9
Tot | 0.115 | W |  |  |  |  |  |  |  |  |  |  |  |  |  |  |  |  |  |  |  |  |  |  |  |  |  |  |  |  |  |  |  |  |  |  |  |  |  |  |  |  |  |  |  |  |  |  |  |  |  |  |  | 25.5 | 25.5
 |  |  |  |  |  |  |  |  |  |  |  |  |  |  |  |  |  |  |  |  |  |  |  |  |  |  |  |  |  |  |  |  |  |  |  |  |  |  |  |  |  |  |  |  |  |  |  |  |  |  |  |  |  | 26.1 | 26.1
 |  |  |  |  |  |  |  |  |  |  |  |  |  |  |  |  |  |  |  |  |  |  |  |  |  |  |  |  |  |  |  |  |  |  |  |  |  |  |  |  |  |  |  |  |  |  |  |  |  |  |  |  |  | 26.7 | 26.7
 |  |  |  |  |  |  |  |  |  |  |  |  |  |  |  |  |  |  |  |  |  |  |  |  |  |  |  |  |  |  |  |  |  |  |  |  |  |  |  |  |  |  |  |  |  |  |  |  |  |  |  |  |  | 27.4 | 27.4
Do not change below |  |  |  |  |  |  |  |  |  |  |  |  |  |  |  |  |  |  |  |  |  |  |  |  |  |  |  |  |  |  |  |  |  |  |  |  |  |  |  |  |  |  |  |  |  |  |  |  |  |  |  |  |  | 28 | 28
 |  |  |  |  |  |  |  |  |  |  |  |  |  |  |  |  |  |  |  |  |  |  |  |  |  |  |  |  |  |  |  |  |  |  |  |  |  |  |  |  |  |  |  |  |  |  |  |  |  |  |  |  |  | 28.7 | 28.7
Vin | Vout | Iout | Rload | Po | Duty | T1 | T2_NON_Sync | T2 | Delta I | I max | Imin | Icrit | Irms HS | Irms LS | F |  | Ton | Toff | L | Pcout | PCIN | Rds ON HS | Pcond | P Ton | P Toff | PDS | PQRR | Pswitch | Gate change | PHS | Rds ON LS | Pcond | Pbd | P | PLS | Pchoke | Poverhead | Ptraces | Ptot | Pin | SOIC8 Theta | Trise | Ttotal | Tmax | Eff |  |  |  |  |  |  |  |  | 29.4 | 29.4
5 | 3.3 |  |  |  |  |  |  |  |  |  |  |  |  |  | 1000000 |  | 1.145198464e-08 | 1.813664596e-08 | 3.6e-06 | 1 | 1 | 0.0811869275 |  |  |  |  |  |  |  |  | 0.026171248 |  |  |  |  | 0.0000 |  |  |  |  | 39 |  | 25 |  |  |  |  |  |  |  |  |  |  | 30.1 | 30.1
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

Sheet: Schematic
Derating
 | Voltage | Current
Capacitors | 50% | 50%
Diodes | 60% | 50%
Inductors |  | 50%
 |  |  | Item | Reference | Value | Unit | Voltage Rating (V) | Current Rating (ARMS) | Current Rating (APP) | ESR/DCR (mΩ) | Tolerance
 |  |  | 1 | C2 | 22 | μF | 10 | 2.42 | NA | 1 | +/-20%
 |  |  | 2 | C3 | 0.01 | μF | 10 | 0.20 | NA | NA | COG
 |  |  | 3 | C4/C5/C6 | 44 | μF | 6.6 | 0.26 | NA | 1 | +/-20%
 |  |  | 5 | CC | 10 | nF | 6.6 | 0.02 | NA | NA | +/-10%
 |  |  | 6 | CF | 430 | pF | 6.6 | 0.02 | NA | NA | +/-10%
 |  |  | 7 | CP | 8.2 | pF | 6.6 | 0.02 | NA | NA | +/-10%
 |  |  | 9 | LOUT | 3.6 | μH | NA | 5.14 | 6.2 | 9.1 | +/-20%
 |  |  | 10 | R1 | 24.31 | kΩ | NA | NA | NA | NA | +/-1%
 |  |  | 11 | R2 | 7.78 | pF | NA | NA | NA | NA | +/-1%
 |  |  | 12 | RC | 4.990 | kΩ | NA | NA | NA | NA | +/-1%
 |  |  | 13 | RF | 1.000 | kΩ | NA | NA | NA | NA | +/-1%
 |  |  | 14 | U1 | NCP3170B | NA | 18.0 | 3 | NA | NA | +/-1%
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
