sgarcia15/Heimdall/Sensor/EsquemaPDF/HTU21D_Board.pdf

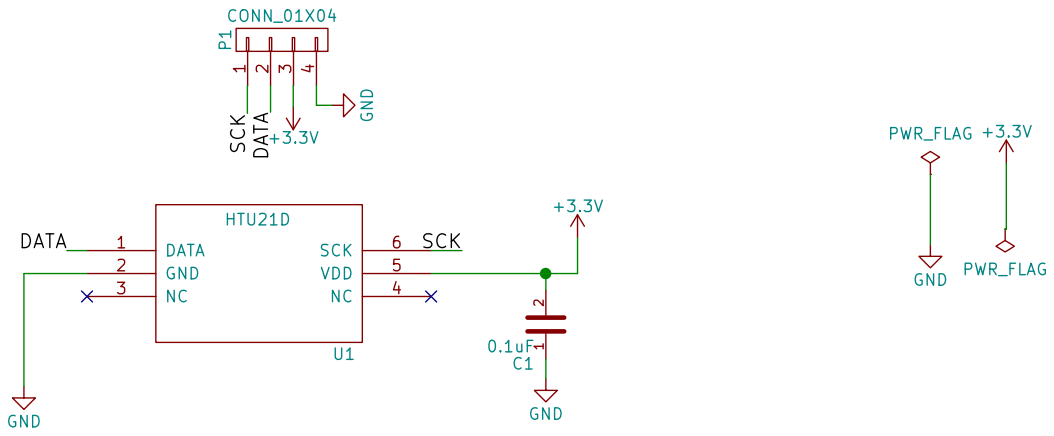
[picture p6: page 1]

4 P1 CONN_01X04 +3.3V GND SCK DATA DATA
