sgarcia15/Heimdall/FireNode-B.Cu.pdf

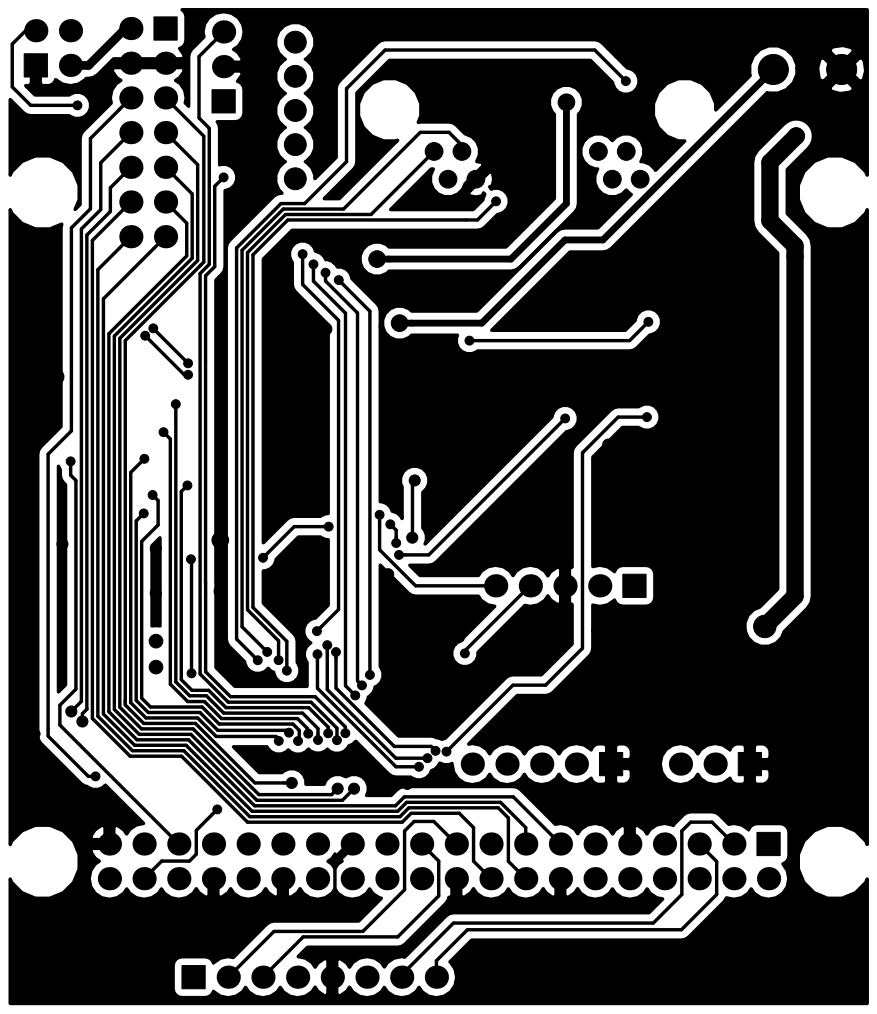
[picture p7: page 1]
