sgarcia15/Heimdall/FireNode-F.Cu.pdf

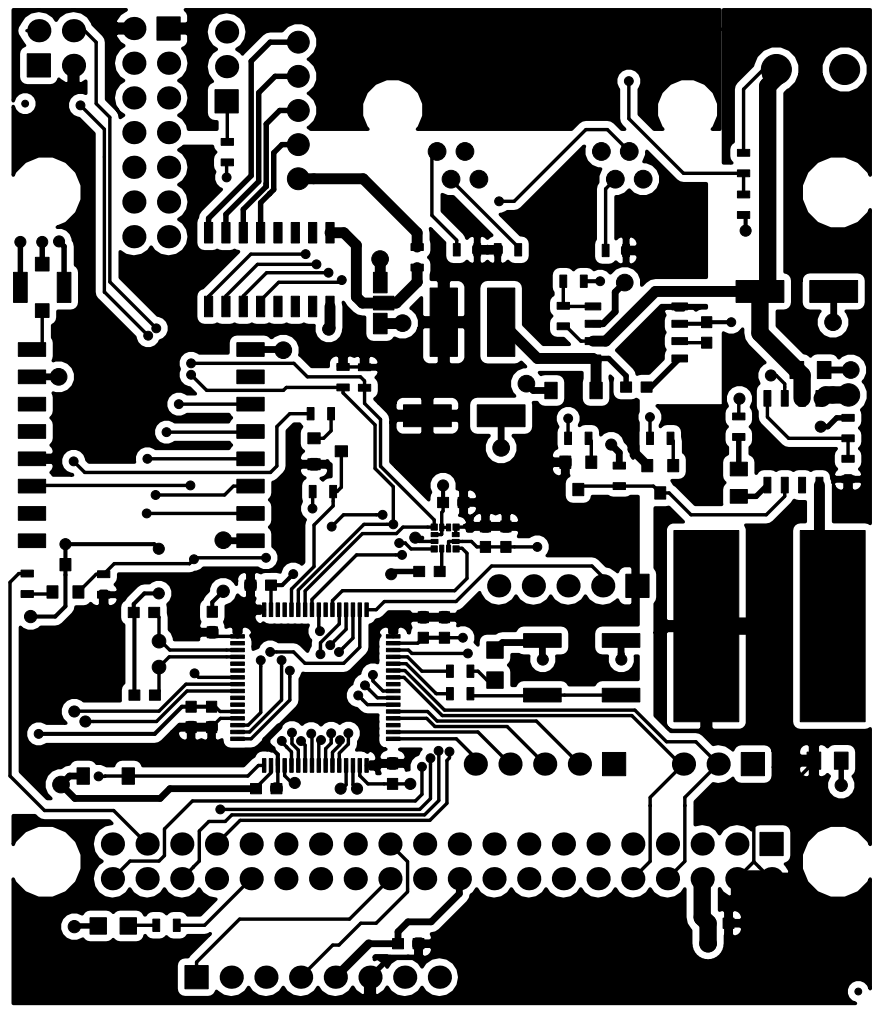
[picture p8: page 1]
