sgarcia15/Heimdall/FireNode.pdf

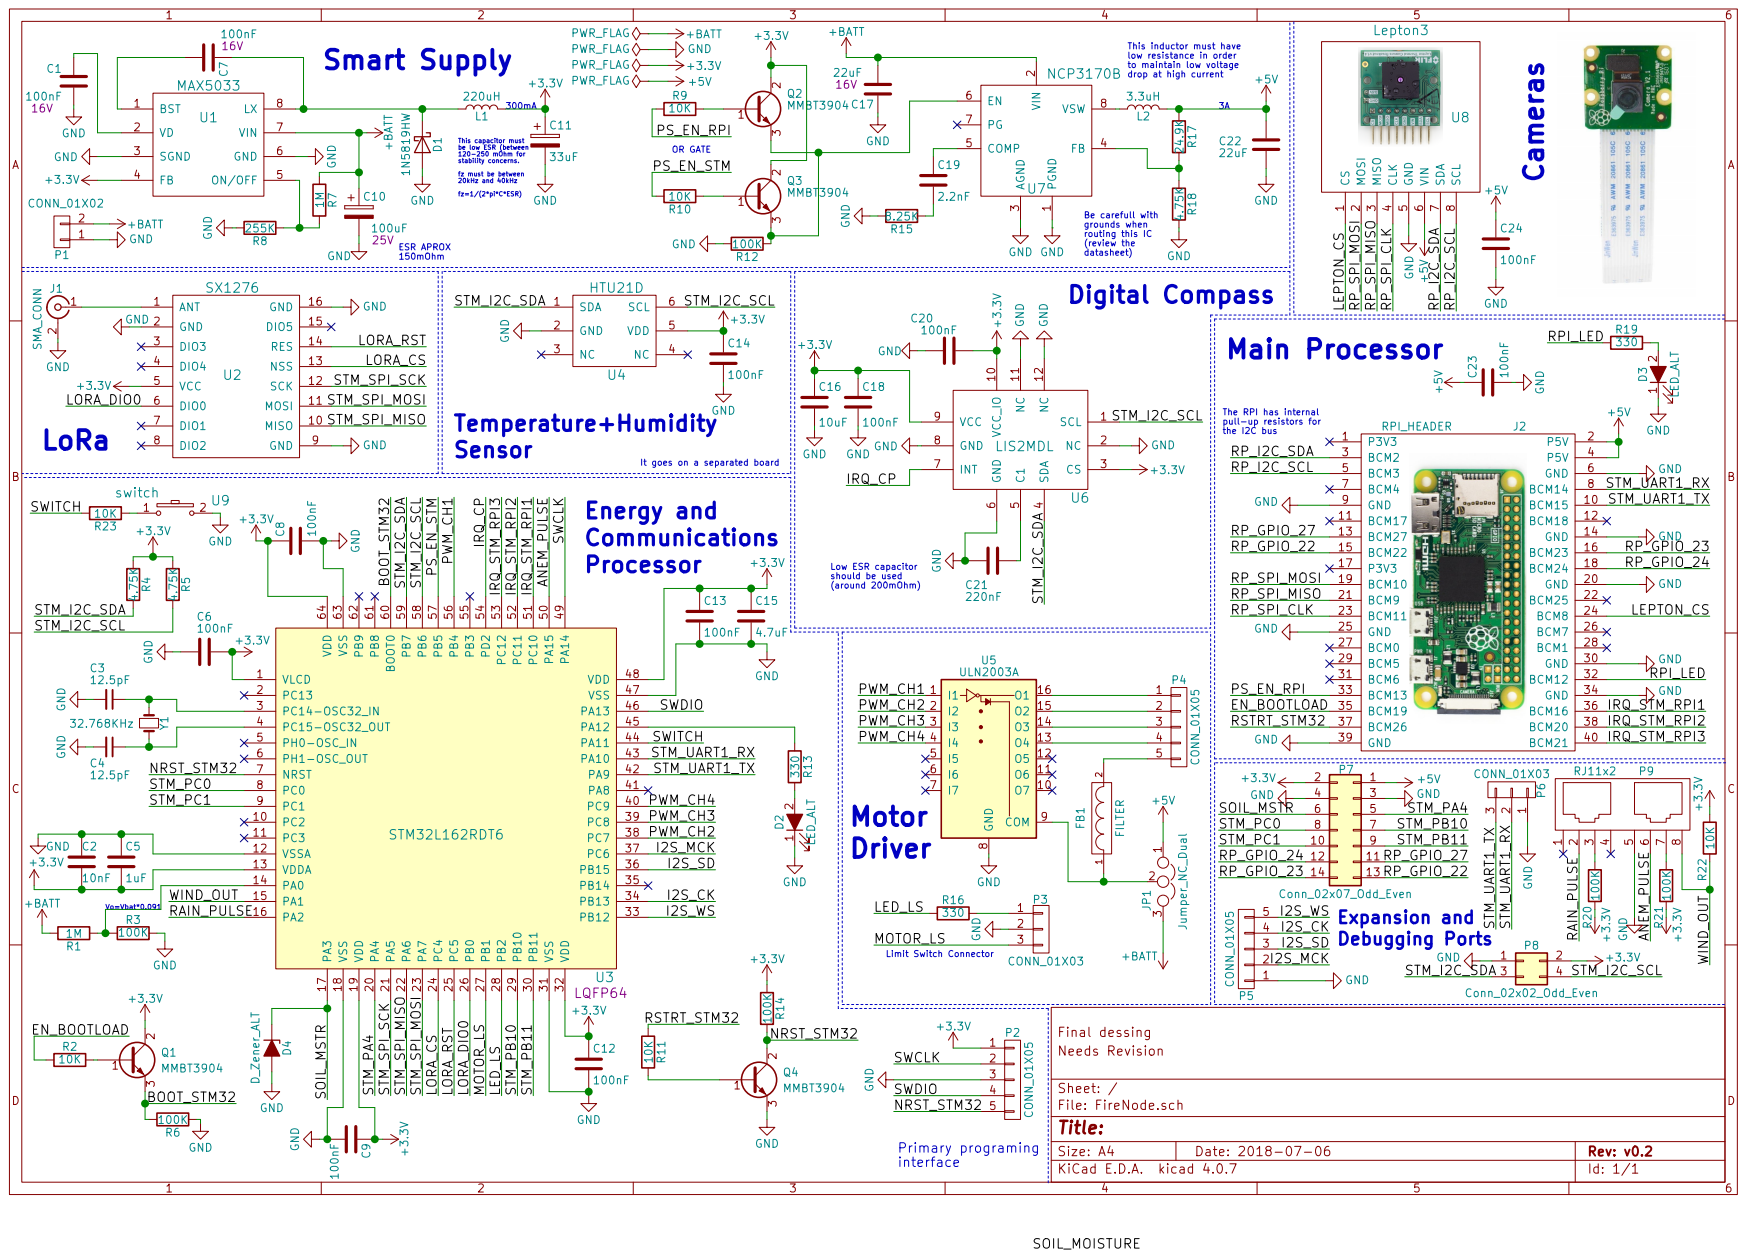
[picture p9: page 1]
