sgarcia15/Heimdall/FireNode.kicad_pcb

## KiCad design FireNode.kicad_pcb (2019-06-19)

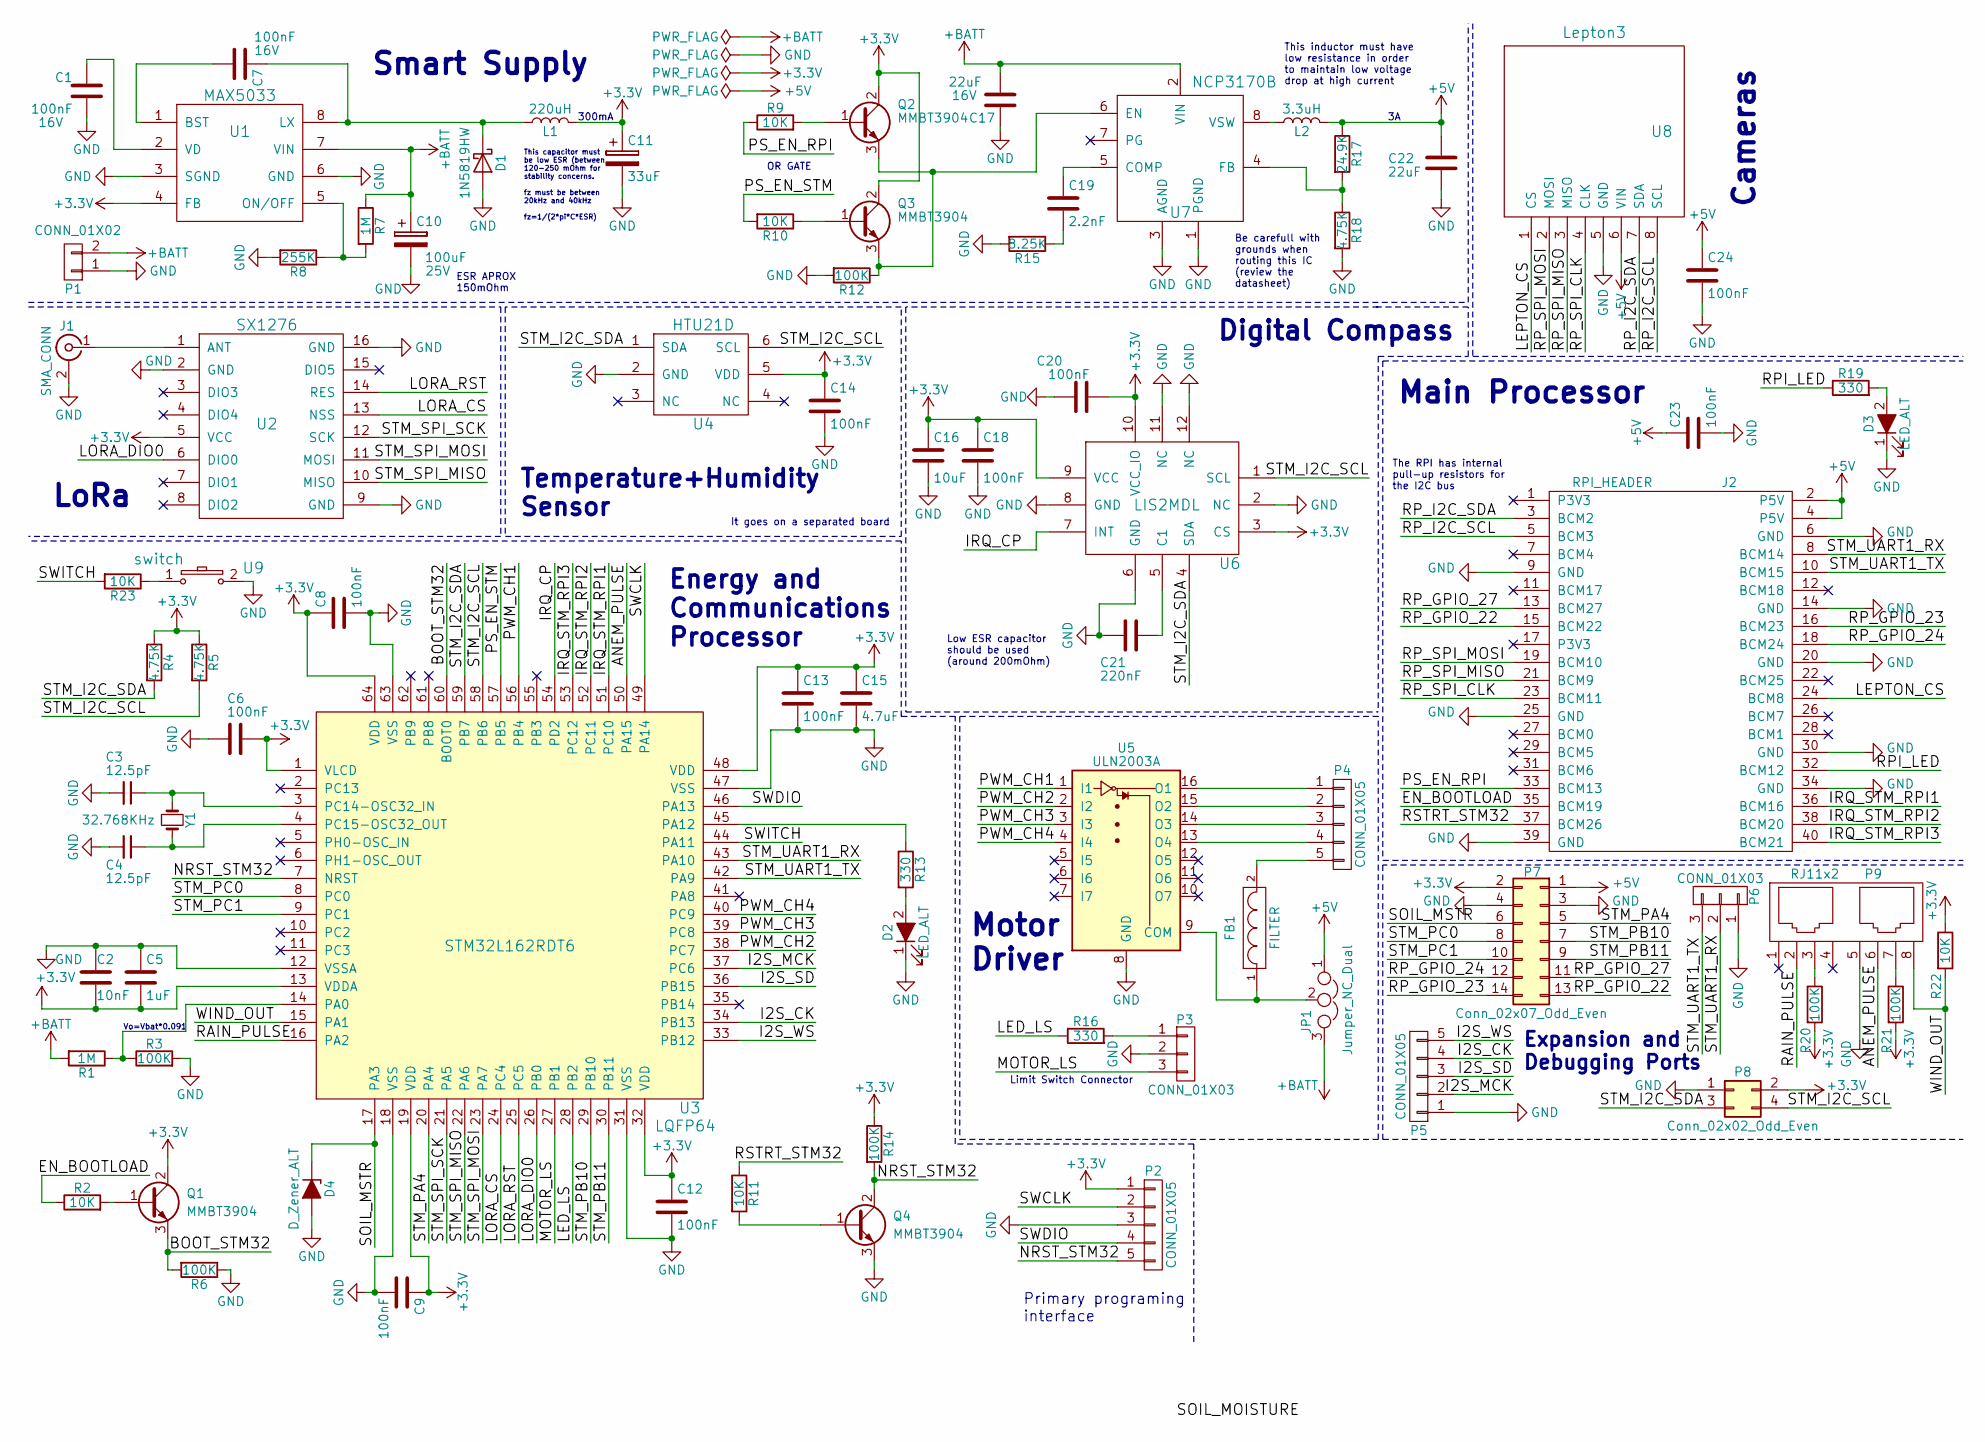
[picture p10: schematic FireNode.sch]

Parts:
C1, C6, C7, C8, C9, C12, C13, C14, C18, C20, C23, C24: 100nF; C_0603
C2: 10nF; C_0603
C3, C4: 12.5pF; C_0603
C5: 1uF; C_0603
C10: 100uF; CP_Elec_6.3x7.7
C11: 33uF; CP_Elec_6.3x5.8
C15: 4.7uF; C_0603
C16: 10uF; C_0603
C17, C22: 22uF; C_0805
C19: 2.2nF; C_0805
C21: 220nF; C_0603
D1: 1N5819HW; D_SOD-123
D2, D3: LED_ALT; LED_0805
D4: D_Zener_ALT; D_SOD-123
FB1: FILTER; L_0603
J1: SMA_CONN; SMA-SMD
J2: RPI_HEADER; Socket_Strip_Straight_2x20_Pitch2.54mm
JP1: Jumper_NC_Dual; SMD-JUMPER
L1: 220uH; IND_6,20X5,25
L2: 3.3uH; IND-6.5mm
P1: CONN_01X02; CONN-5mm
P2, P5: CONN_01X05; Pin_Header_Straight_1x05_Pitch2.54mm
P3, P6: CONN_01X03; Pin_Header_Straight_1x03_Pitch2.54mm
P4: CONN_01X05; CONN-MOT-5
P7: Conn_02x07_Odd_Even; Socket_Strip_Straight_2x07_Pitch2.54mm
P8: Conn_02x02_Odd_Even; Pin_Header_Straight_2x02_Pitch2.54mm
P9: RJ11x2; 2xRJ11
Q1, Q2, Q3, Q4: MMBT3904; SOT-23
R1, R7: 1M; R_0603
R2, R9, R10, R11, R22, R23: 10K; R_0603
R3, R6, R12, R14, R20, R21: 100K; R_0603
R4, R5, R18: 4.75K; R_0603
R8: 255K; R_0603
R13, R16, R19: 330; R_0603
R15: 8.25K; R_0603
R17: 24.9K; R_0603
U1: MAX5033; SOIC-8-N
U2: SX1276
U3: STM32L162RDT6; LQFP-64_10x10mm_Pitch0.5mm
U4: HTU21D
U5: ULN2003A; SOIC-16_3.9x9.9mm_Pitch1.27mm
U6: LIS2MDL; LGA-12_2x2mm_Pitch0.5mm
U7: NCP3170B; SOIC-8-N
U8: Lepton3; Pin_Header_Straight_1x08_Pitch2.54mm
U9: switch; SW_SPST_EVPBF
Y1: 32.768KHz; Crystal_C38-LF_d3.0mm_l8.0mm_Horizontal

Connections:
+3V3: C2.2, C5.2, C6.1, C8.1, C9.1, C11.1, C12.1, C13.1, C14.1, C15.1, C16.1, C18.1, C20.2, L1.2, P2.1, P7.2, P8.2, Q1.2 (C), Q2.2 (C), Q3.2 (C), R4.1, R5.1, R14.1, R20.2, R21.2, R22.1, U1.4 (FB), U2.5 (VCC), U3.1 (VLCD), U3.13 (VDDA), U3.19 (VDD), U3.32 (VDD), U3.48 (VDD), U3.64 (VDD), U4.5 (VDD), U6.3 (CS), U6.9 (VCC), U6.10 (VCC_IO)
+5V: C22.1, C23.1, C24.1, J2.2 (P5V), J2.4 (P5V), JP1.1, L2.2, P7.1, R17.1, U8.6 (VIN)
+BATT: C10.1, C17.2, JP1.3, P1.2, R1.2, R7.1, U1.7 (VIN), U7.2 (VIN)
/ANEM_PULSE: P9.6, U3.50 (PA15)
/BOOT_STM32: Q1.3 (E), R6.2, U3.60 (BOOT0)
/EN_BOOTLOAD: J2.35 (BCM19), R2.1
/I2S_CK: P5.4, U3.34 (PB13)
/I2S_MCK: P5.2, U3.37 (PC6)
/I2S_SD: P5.3, U3.36 (PB15)
/I2S_WS: P5.5, U3.33 (PB12)
/IRQ_CP: U3.54 (PD2), U6.7 (INT)
/IRQ_STM_RPI1: J2.36 (BCM16), U3.51 (PC10)
/IRQ_STM_RPI2: J2.38 (BCM20), U3.52 (PC11)
/IRQ_STM_RPI3: J2.40 (BCM21), U3.53 (PC12)
/LED_LS: R16.1, U3.28 (PB2)
/LEPTON_CS: J2.24 (BCM8), U8.1 (CS)
/LORA_CS: U2.13 (NSS), U3.24 (PC4)
/LORA_DIO0: U2.6 (DIO0), U3.26 (PB0)
/LORA_RST: U2.14 (RES), U3.25 (PC5)
/MOTOR_LS: P3.3 (P2), U3.27 (PB1)
/NRST_STM32: P2.5, Q4.2 (C), R14.2, U3.7 (NRST)
/PS_EN_RPI: J2.33 (BCM13), R9.1
/PS_EN_STM: R10.2, U3.57 (PB5)
/PWM_CH1: U3.56 (PB4), U5.1 (I1)
/PWM_CH2: U3.38 (PC7), U5.2 (I2)
/PWM_CH3: U3.39 (PC8), U5.3 (I3)
/PWM_CH4: U3.40 (PC9), U5.4 (I4)
/RAIN_PULSE: P9.2, U3.16 (PA2)
/RPI_LED: J2.32 (BCM12), R19.1
/RP_GPIO_22: J2.15 (BCM22), P7.13
/RP_GPIO_23: J2.16 (BCM23), P7.14
/RP_GPIO_24: J2.18 (BCM24), P7.12
/RP_GPIO_27: J2.13 (BCM27), P7.11
/RP_I2C_SCL: J2.5 (BCM3), U8.8 (SCL)
/RP_I2C_SDA: J2.3 (BCM2), U8.7 (SDA)
/RP_SPI_CLK: J2.23 (BCM11), U8.4 (CLK)
/RP_SPI_MISO: J2.21 (BCM9), U8.3 (MISO)
/RP_SPI_MOSI: J2.19 (BCM10), U8.2 (MOSI)
/RSTRT_STM32: J2.37 (BCM26), R11.1
/SOIL_MSTR: D4.1 (K), P7.6, U3.17 (PA3)
/STM_I2C_SCL: P8.4, R5.2, U3.58 (PB6), U4.6 (SCL), U6.1 (SCL)
/STM_I2C_SDA: P8.3, R4.2, U3.59 (PB7), U4.1 (SDA), U6.4 (SDA)
/STM_PA4: P7.5, U3.20 (PA4)
/STM_PB10: P7.7, U3.29 (PB10)
/STM_PB11: P7.9, U3.30 (PB11)
/STM_PC0: P7.8, U3.8 (PC0)
/STM_PC1: P7.10, U3.9 (PC1)
/STM_SPI_MISO: U2.10 (MISO), U3.22 (PA6)
/STM_SPI_MOSI: U2.11 (MOSI), U3.23 (PA7)
/STM_SPI_SCK: U2.12 (SCK), U3.21 (PA5)
/STM_UART1_RX: J2.8 (BCM14), P6.2 (P1), U3.43 (PA10)
/STM_UART1_TX: J2.10 (BCM15), P6.3 (P2), U3.42 (PA9)
/SWCLK: P2.2, U3.49 (PA14)
/SWDIO: P2.4, U3.46 (PA13)
/SWITCH: R23.2, U3.44 (PA11)
/WIND_OUT: P9.8, R22.2, U3.15 (PA1)
GND: C1.1, C2.1, C3.2, C4.2, C5.1, C6.2, C8.2, C9.2, C10.2, C11.2, C12.2, C13.2, C14.2, C15.2, C16.2, C17.1, C18.2, C20.1, C21.2, C22.2, C23.2, C24.2, D1.2 (A), D2.1 (K), D3.1 (K), D4.2 (A), J1.2 (Ext), J2.6 (GND), J2.9 (GND), J2.14 (GND), J2.20 (GND), J2.25 (GND), J2.30 (GND), J2.34 (GND), J2.39 (GND), P1.1, P2.3, P3.2 (P1), P5.1, P6.1, P7.3, P7.4, P8.1, P9.5, Q4.3 (E), R3.2, R6.1, R8.2, R12.2, R15.2, R18.2, U1.3 (SGND), U1.6 (GND), U2.2 (GND), U2.9 (GND), U2.16 (GND), U3.12 (VSSA), U3.18 (VSS), U3.31 (VSS), U3.47 (VSS), U3.63 (VSS), U4.2 (GND), U5.8 (GND), U6.2 (NC), U6.6 (GND), U6.8 (GND), U6.11 (NC), U6.12 (NC), U7.1 (PGND), U7.3 (AGND), U8.5 (GND), U9.2
unnamed: C1.2, U1.2 (VD)
unnamed: C3.1, U3.3 (PC14-OSC32_IN), Y1.1
unnamed: C4.1, U3.4 (PC15-OSC32_OUT), Y1.2
unnamed: C7.1, D1.1 (K), L1.1, U1.8 (LX)
unnamed: C7.2, U1.1 (BST)
unnamed: C19.1, U7.5 (COMP)
unnamed: C19.2, R15.1
unnamed: C21.1, U6.5 (C1)
unnamed: D2.2 (A), R13.2
unnamed: D3.2 (A), R19.2
unnamed: FB1.1, JP1.2, U5.9 (COM)
unnamed: FB1.2, P4.5
unnamed: J1.1 (In), U2.1 (ANT)
unnamed: L2.1, U7.8 (VSW)
unnamed: P3.1, R16.2
unnamed: P4.1, U5.16 (O1)
unnamed: P4.2, U5.15 (O2)
unnamed: P4.3, U5.14 (O3)
unnamed: P4.4, U5.13 (O4)
unnamed: P9.3, R20.1
unnamed: P9.7, R21.1
unnamed: Q1.1 (B), R2.2
unnamed: Q2.1 (B), R9.2
unnamed: Q2.3 (E), Q3.3 (E), R12.1, U7.6 (EN)
unnamed: Q3.1 (B), R10.1
unnamed: Q4.1 (B), R11.2
unnamed: R1.1, R3.1, U3.14 (PA0)
unnamed: R7.2, R8.1, U1.5 (ON/OFF)
unnamed: R13.1, U3.45 (PA12)
unnamed: R17.2, R18.1, U7.4 (FB)
unnamed: R23.1, U9.1

Notes on the sheet:
ESR APROX 150mOhm
This capacitor must be low ESR (between 120-250 mOhm for stability concerns. fz must be between 20kHz and 40kHz fz=1/(2*pi*C*ESR)
Low ESR capacitor should be used (around 200mOhm)
The RPI has internal pull-up resistors for the I2C bus
Be carefull with grounds when routing this IC (review the datasheet)
Primary programing interface
Smart Supply
Cameras
Main Processor
Vo=Vbat*0.091
LoRa
Temperature+Humidity Sensor
Digital Compass
Expansion and Debugging Ports
Motor Driver
Limit Switch Connector
Energy and Communications Processor
This inductor must have low resistance in order to maintain low voltage drop at high current
It goes on a separated board
300mA
OR GATE

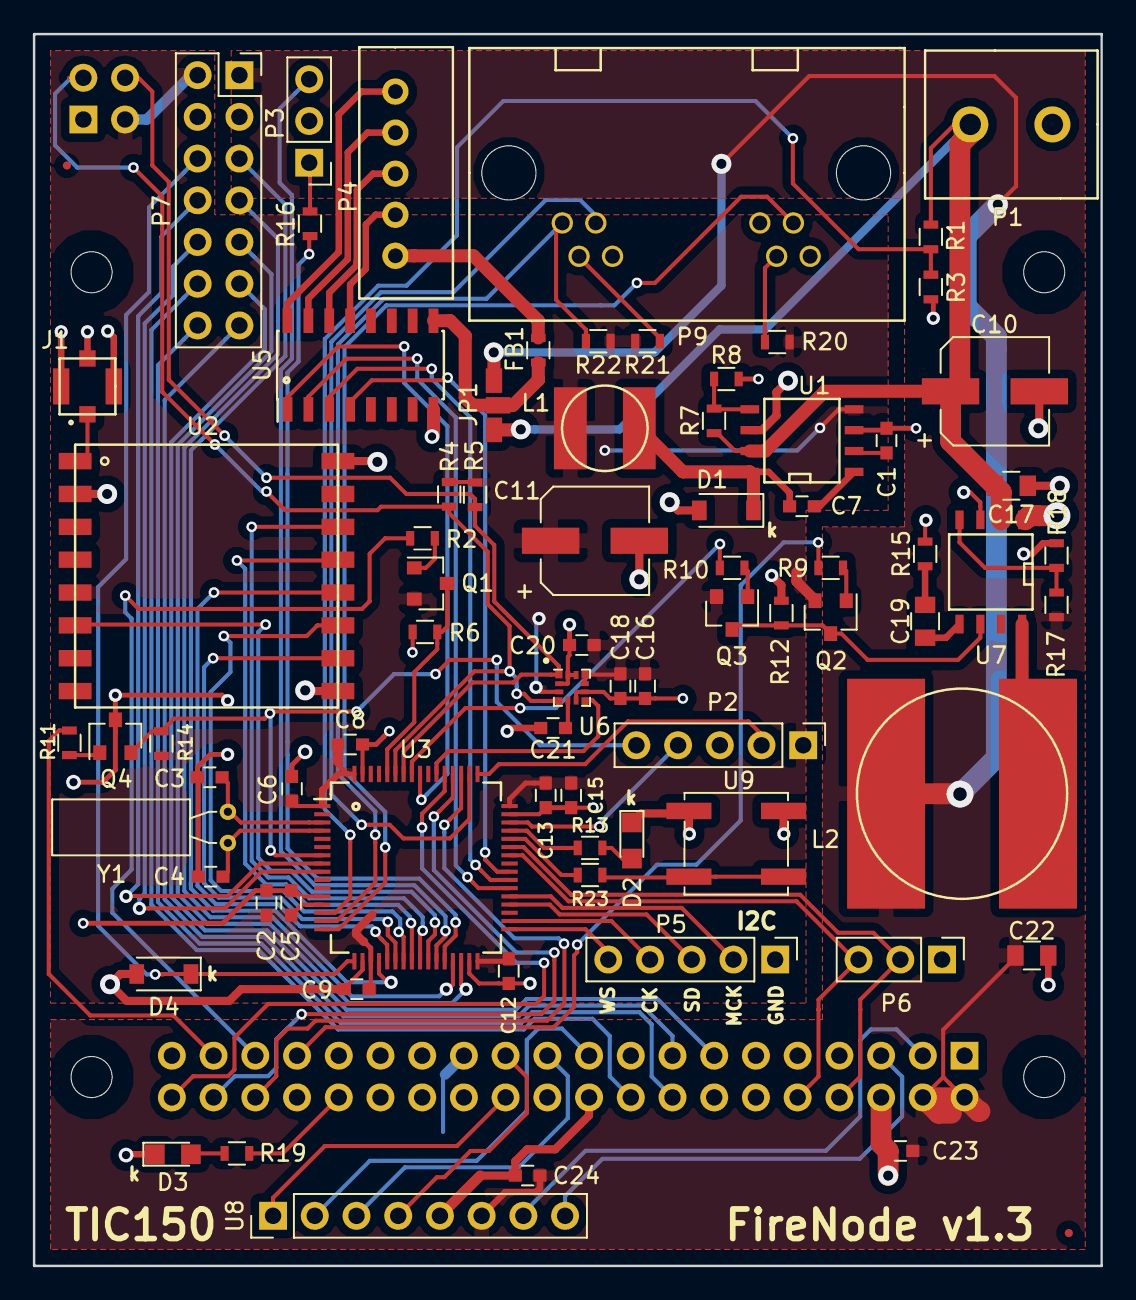
[picture p11: board FireNode.kicad_pcb from above]

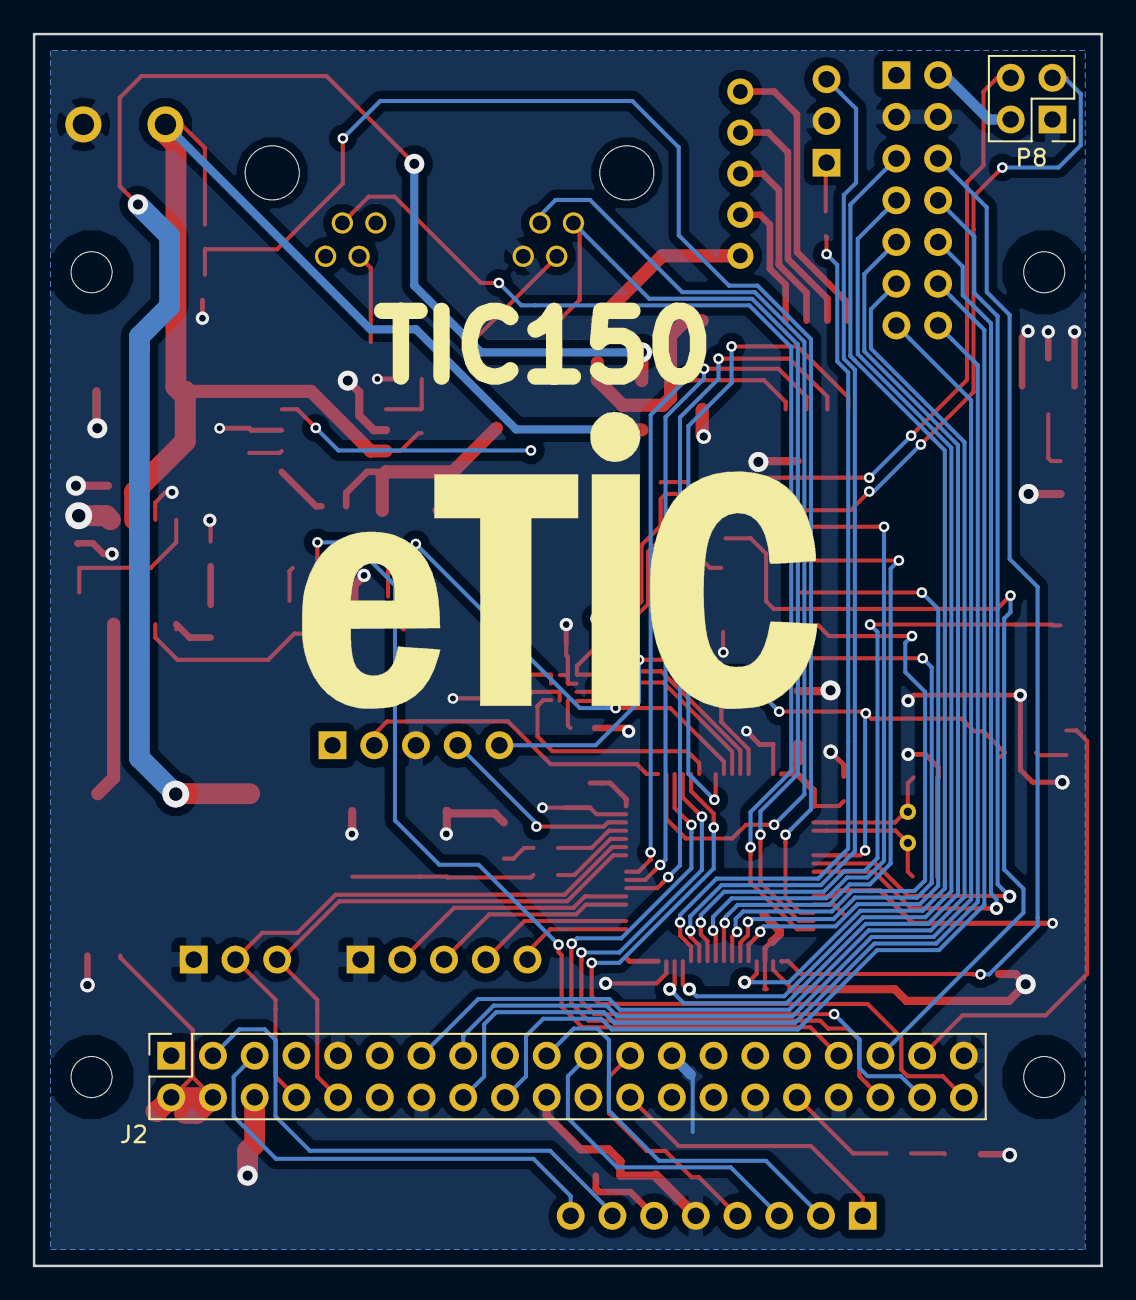
[picture p12: board FireNode.kicad_pcb from below]

Board: 2 copper layers, 65.0 x 75.0 mm, 78 parts (2 on the bottom side), 88 nets.
